essensys-hub/essensys-doc/archi/index.md

# Architecture du Systeme Essensys

Cette documentation decrit l'architecture logicielle et systeme de l'ecosysteme Essensys, en s'appuyant sur les principes du modele C4 (Context, Containers, Components, Code) et l'approche *Clean Architecture*.

## 1. Contexte du Systeme (System Context)

Le systeme Essensys est une solution domotique concue initialement autour de cartes materielles embarquees (BP_MQX_ETH). Le defi majeur de l'architecture actuelle est de moderniser l'acces et le controle de ce materiel "legacy" tout en assurant une retrocompatibilite totale.

### Objectif Principal

Fournir une interface de controle moderne, securisee et performante (via des dashboards web, mobile, ou messagerie WhatsApp) tout en dialoguant avec un parc materiel existant dont les capacites reseau et logiques (firmware C sur Coldfire MCF52259) sont figees.

### Diagramme de Contexte

```mermaid
graph TB
    user["👤 Utilisateur Final<br/>Navigateur / Mobile / WhatsApp"]
    admin["🔧 Administrateur<br/>SSH / HTTPS / Control Plane"]

    essensys["🏠 Ecosysteme Essensys<br/>Chauffage, volets, eclairage,<br/>alarme, securite"]

    hardware["🔌 Cartes BP_MQX_ETH<br/>Coldfire MCF52259 / MQX RTOS"]
    whatsapp["📱 WhatsApp<br/>Notifications via OpenClaw"]
    homeassistant["🏠 Home Assistant<br/>MQTT Discovery"]
    linky["⚡ Compteur Linky<br/>Teleinfo UART 1200 bauds"]
    unifi["📷 UniFi Protect<br/>Cameras IP"]
    dockerhub["🐳 Docker Hub<br/>Registry images"]
    github["⚙️ GitHub Actions<br/>CI/CD multi-arch"]

    user -->|HTTPS / WhatsApp| essensys
    admin -->|SSH / HTTPS| essensys
    essensys <-->|Polling HTTP 2s<br/>Port 80 / LAN| hardware
    essensys <-->|API WhatsApp Web| whatsapp
    essensys <-->|MQTT| homeassistant
    hardware <---|UART 1200 bauds| linky
    essensys -->|HTTPS| unifi
    github -->|Docker Push ARM64/AMD64| dockerhub
    admin -->|Git Push| github

    classDef system fill:#438DD5,stroke:#2E6295,color:#fff
    classDef external fill:#999,stroke:#666,color:#fff
    classDef person fill:#08427B,stroke:#052E56,color:#fff

    class essensys system
    class hardware,whatsapp,homeassistant,linky,unifi,dockerhub,github external
    class user,admin person
```
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
