essensys-hub/essensys-doc/docs/etudes/img/banc/cartes.png

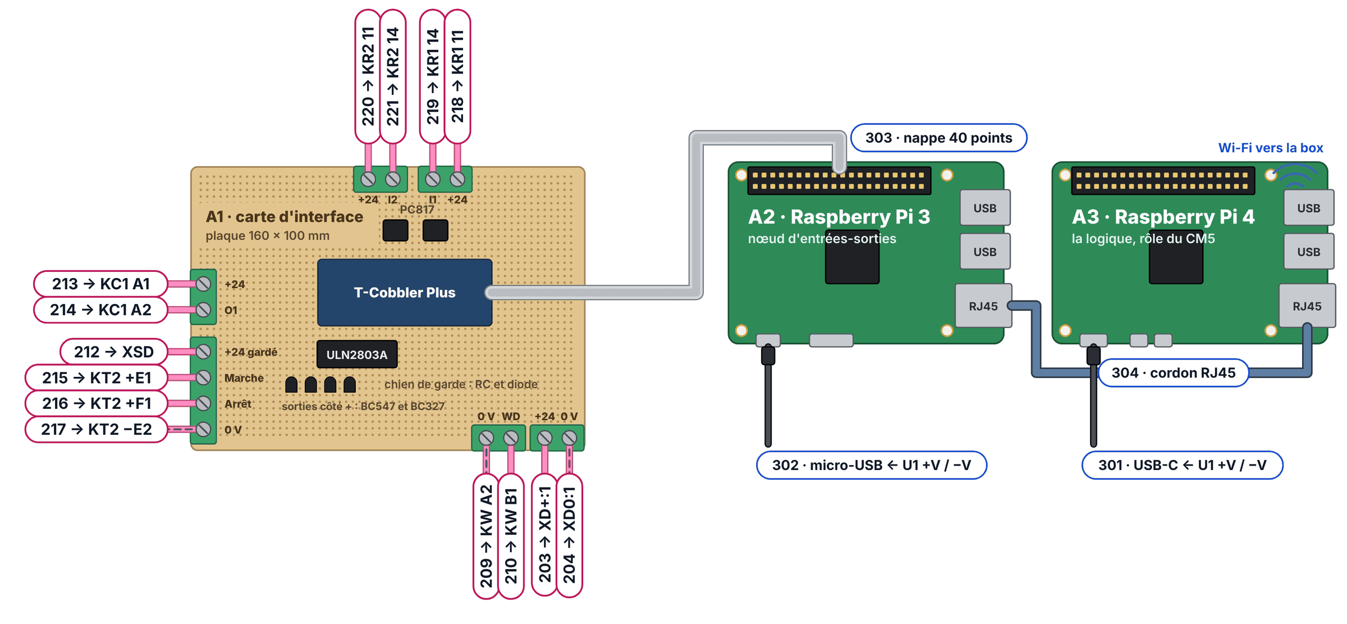
docs/etudes/img/banc/cartes.png
