essensys-hub/essensys-doc/docs/etudes/img/banc/ensemble.png

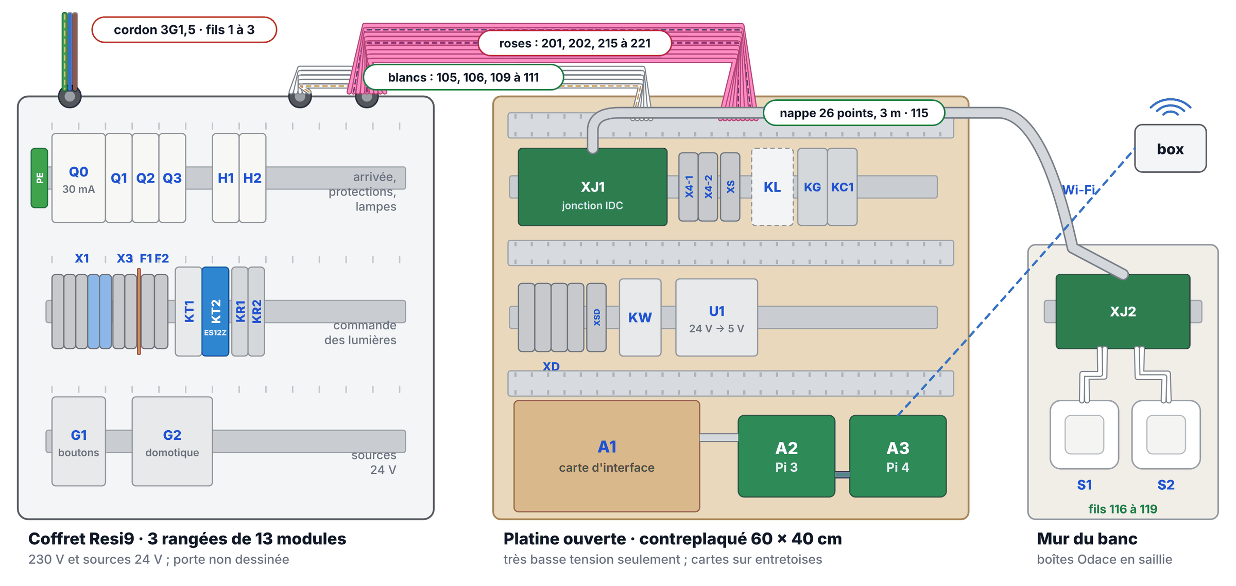
docs/etudes/img/banc/ensemble.png
