essensys-hub/essensys-doc/docs/etudes/img/banc/fritzing-une-lumiere.png

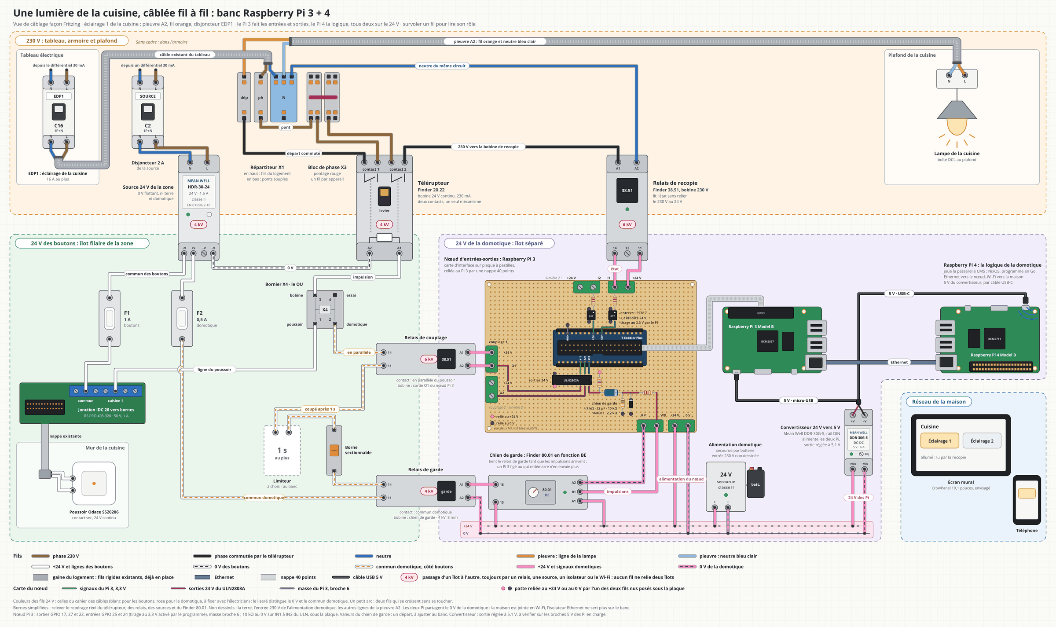
docs/etudes/img/banc/fritzing-une-lumiere.png
