essensys-hub/essensys-doc/docs/etudes/img/banc/rail-C1.png

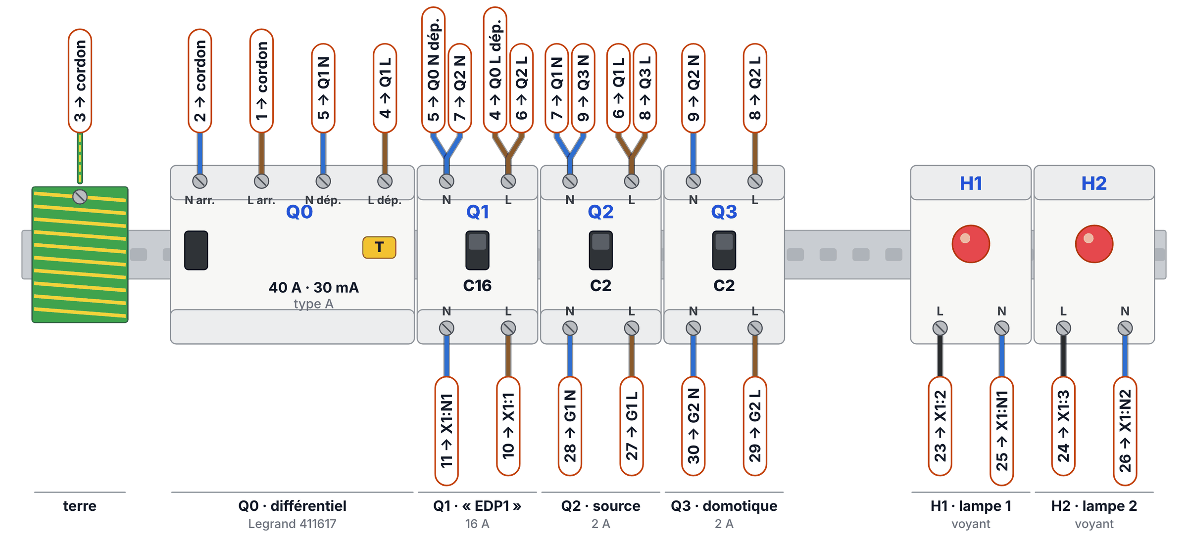
docs/etudes/img/banc/rail-C1.png
