essensys-hub/essensys-doc/docs/etudes/img/banc/rail-C3.png

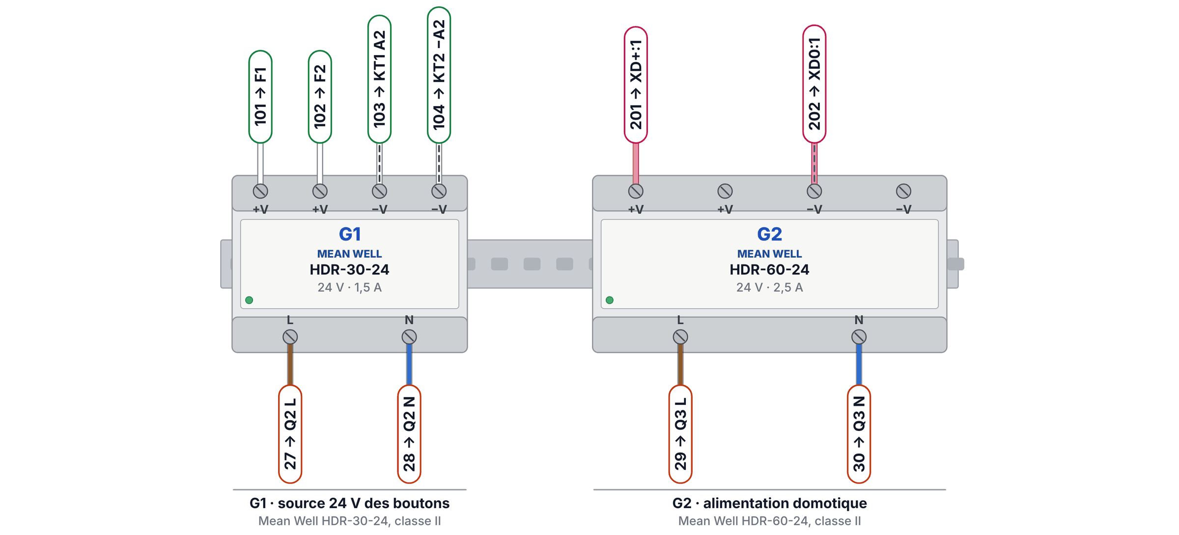
docs/etudes/img/banc/rail-C3.png
