essensys-hub/essensys-doc/docs/etudes/img/banc/rail-P1.png

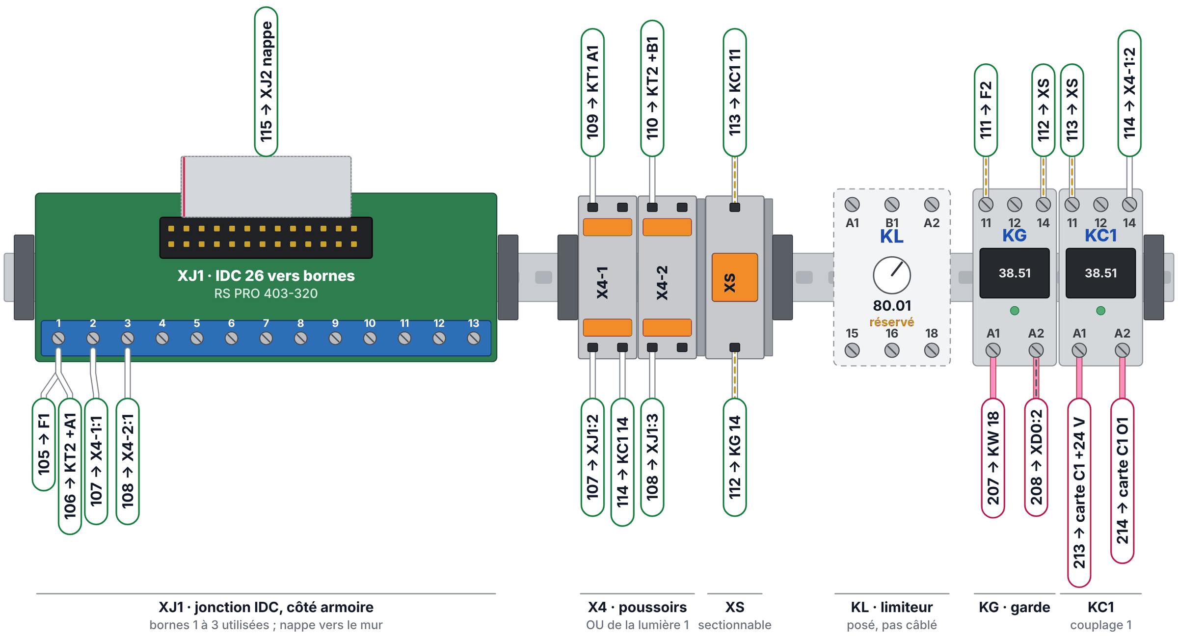
docs/etudes/img/banc/rail-P1.png
