essensys-hub/essensys-doc/docs/etudes/remplacement-armoire/img/alimentation-revpi.png

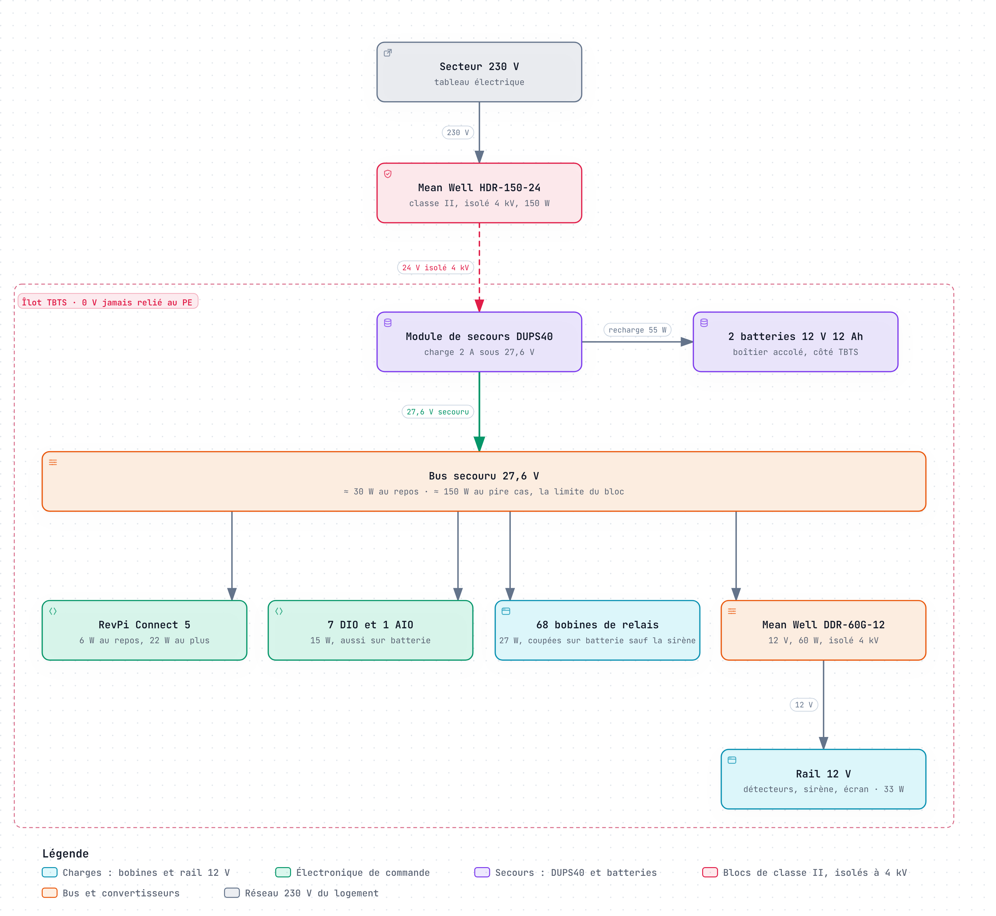
docs/etudes/remplacement-armoire/img/alimentation-revpi.png
