essensys-hub/essensys-doc/docs/etudes/remplacement-armoire/img/architecture-revpi-cible.png

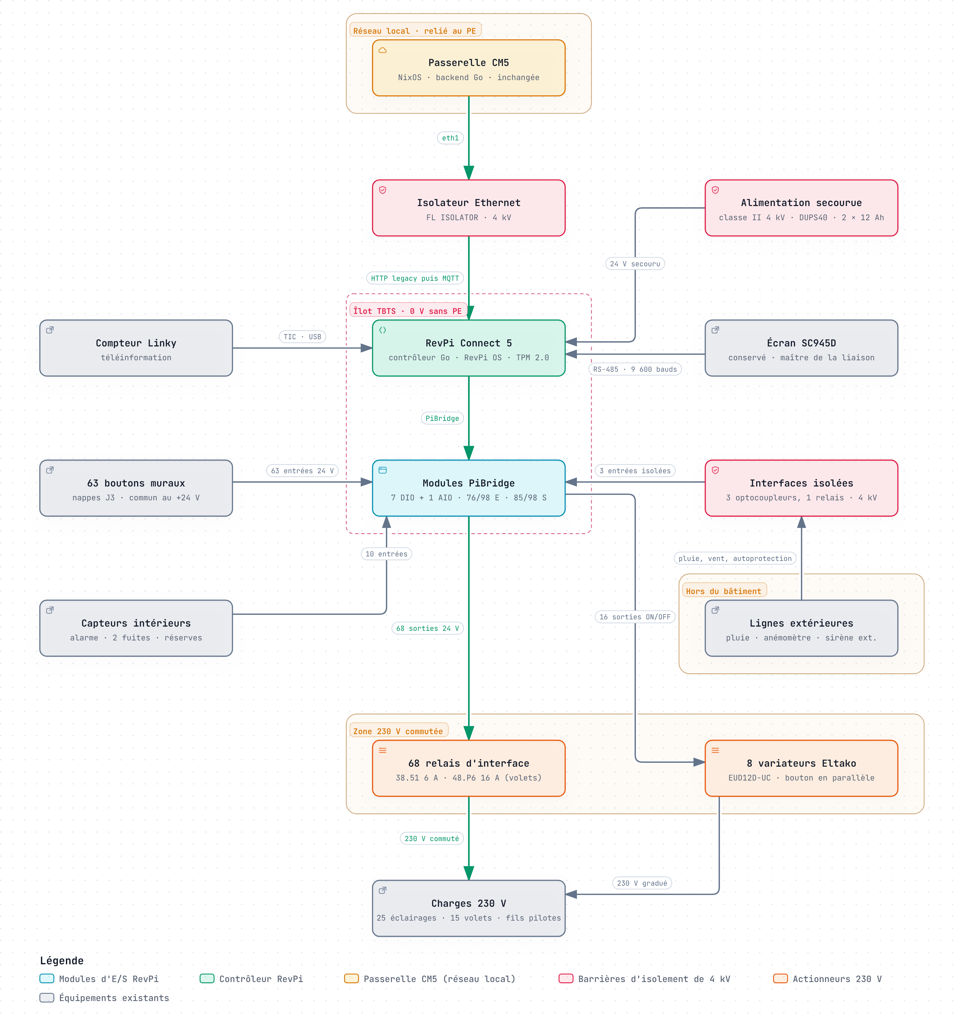
docs/etudes/remplacement-armoire/img/architecture-revpi-cible.png
