essensys-hub/essensys-doc/docs/etudes/remplacement-armoire/img/detail-jonctions-rpi.jpg

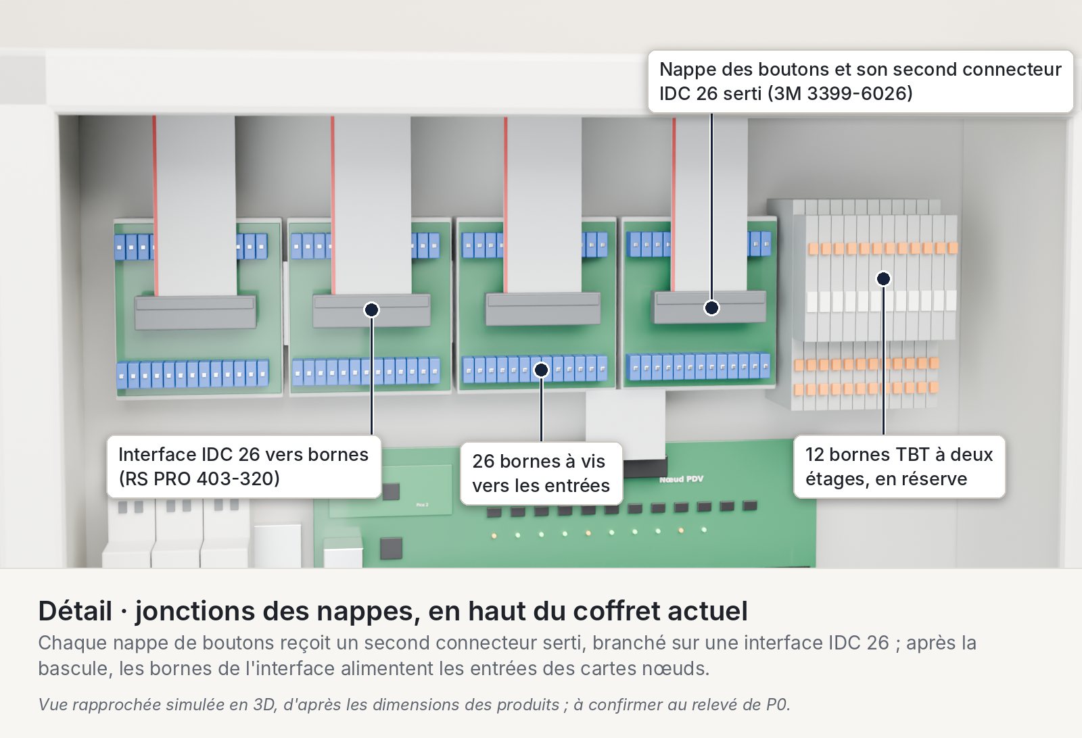
docs/etudes/remplacement-armoire/img/detail-jonctions-rpi.jpg
