essensys-hub/essensys-doc/docs/etudes/remplacement-armoire/img/detail-phases-revpi.jpg

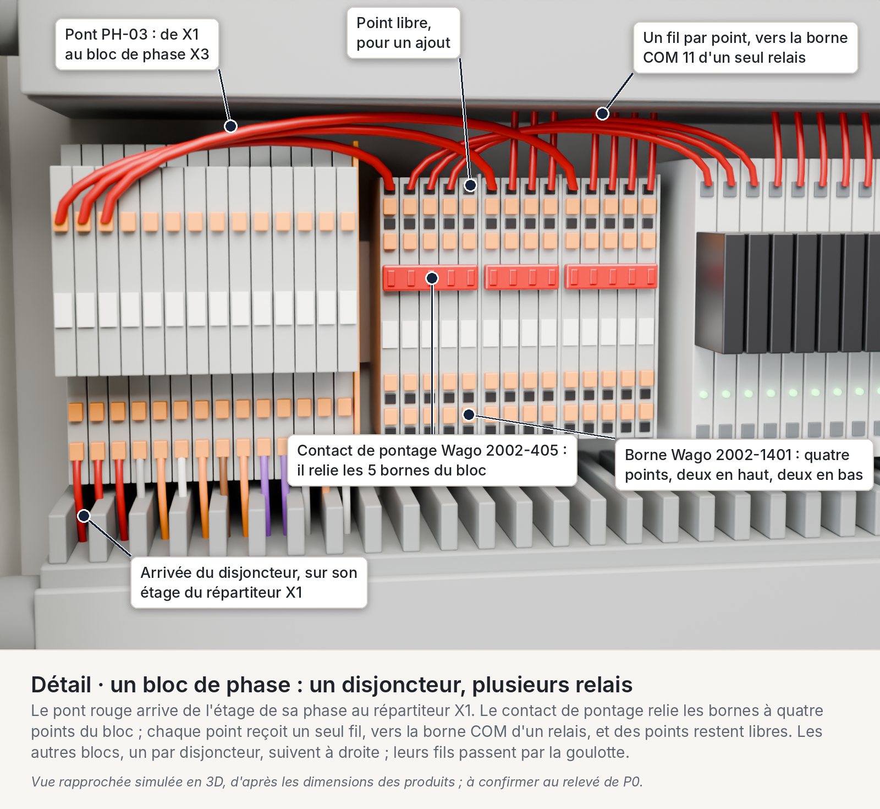
docs/etudes/remplacement-armoire/img/detail-phases-revpi.jpg
