essensys-hub/essensys-doc/docs/etudes/remplacement-armoire/img/detail-phases-rpi.jpg

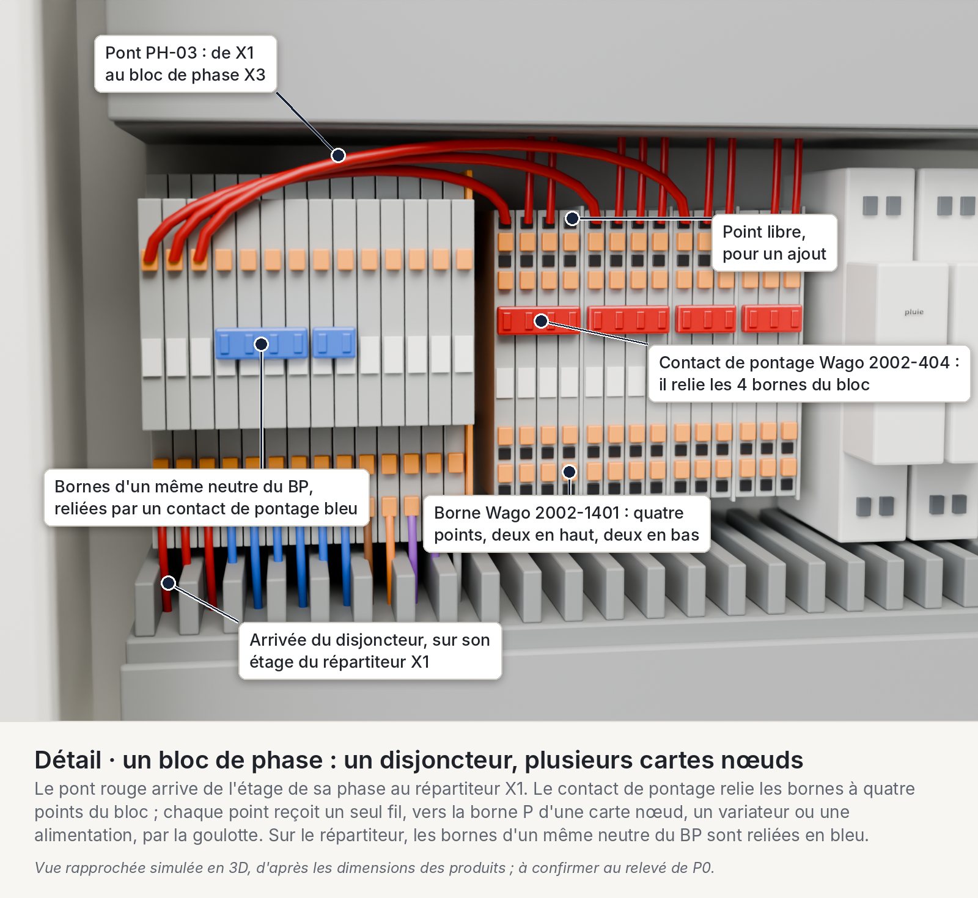
docs/etudes/remplacement-armoire/img/detail-phases-rpi.jpg
