essensys-hub/essensys-doc/docs/etudes/remplacement-armoire/img/detail-repartiteur-revpi.jpg

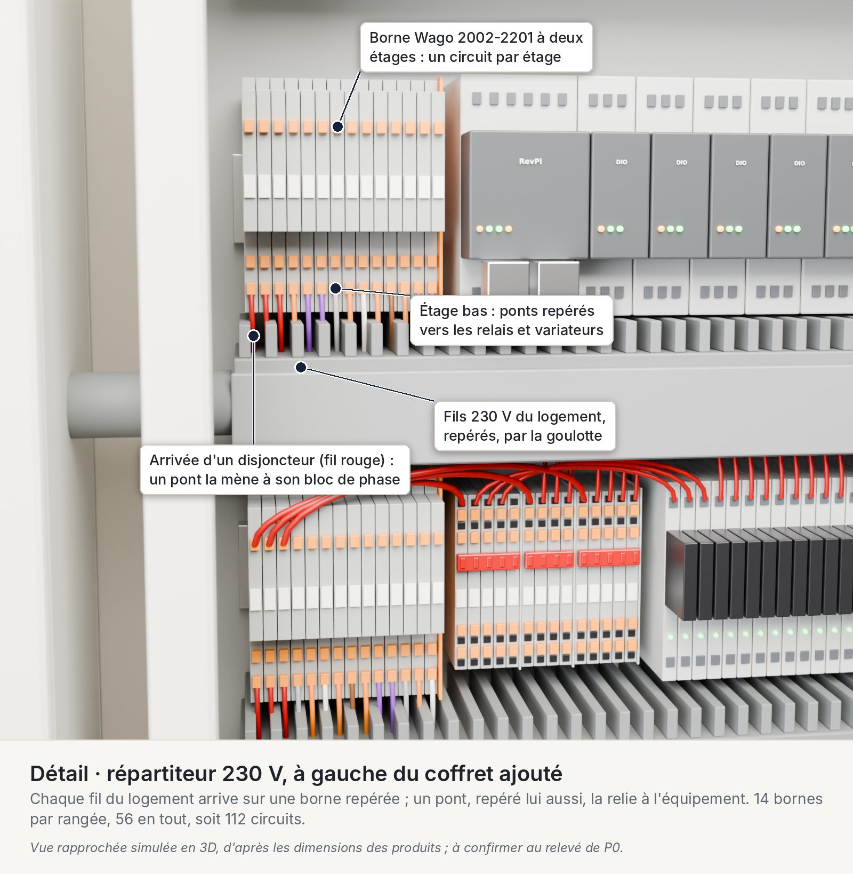
docs/etudes/remplacement-armoire/img/detail-repartiteur-revpi.jpg
