essensys-hub/essensys-doc/docs/etudes/remplacement-armoire/img/detail-repartiteur-rpi.jpg

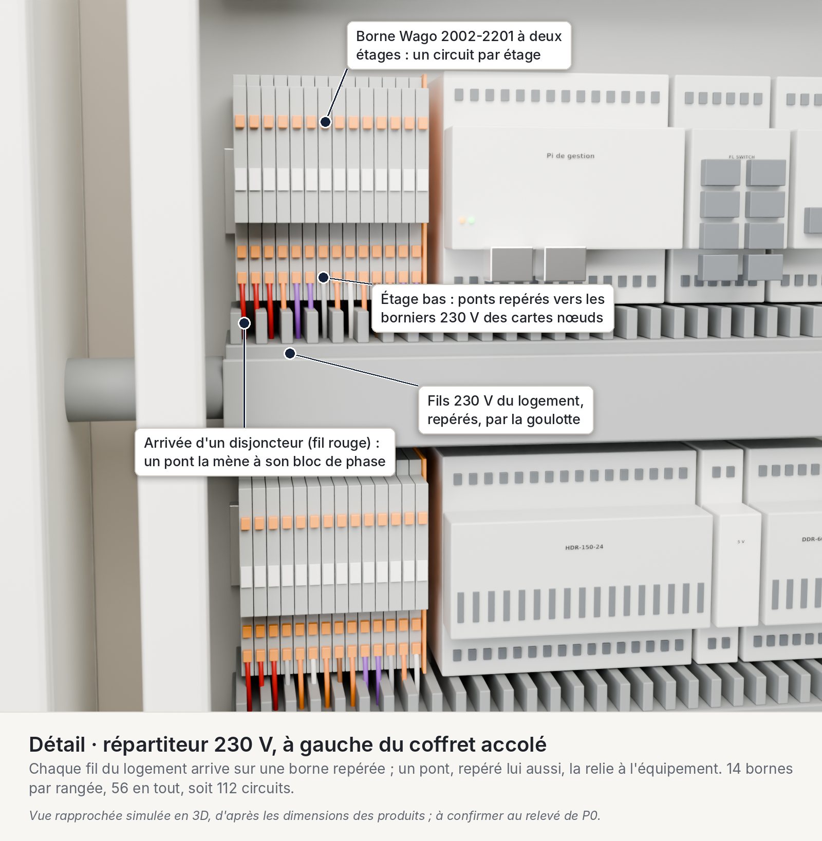
docs/etudes/remplacement-armoire/img/detail-repartiteur-rpi.jpg
