essensys-hub/essensys-doc/docs/etudes/remplacement-armoire/img/implantation-rpi.png

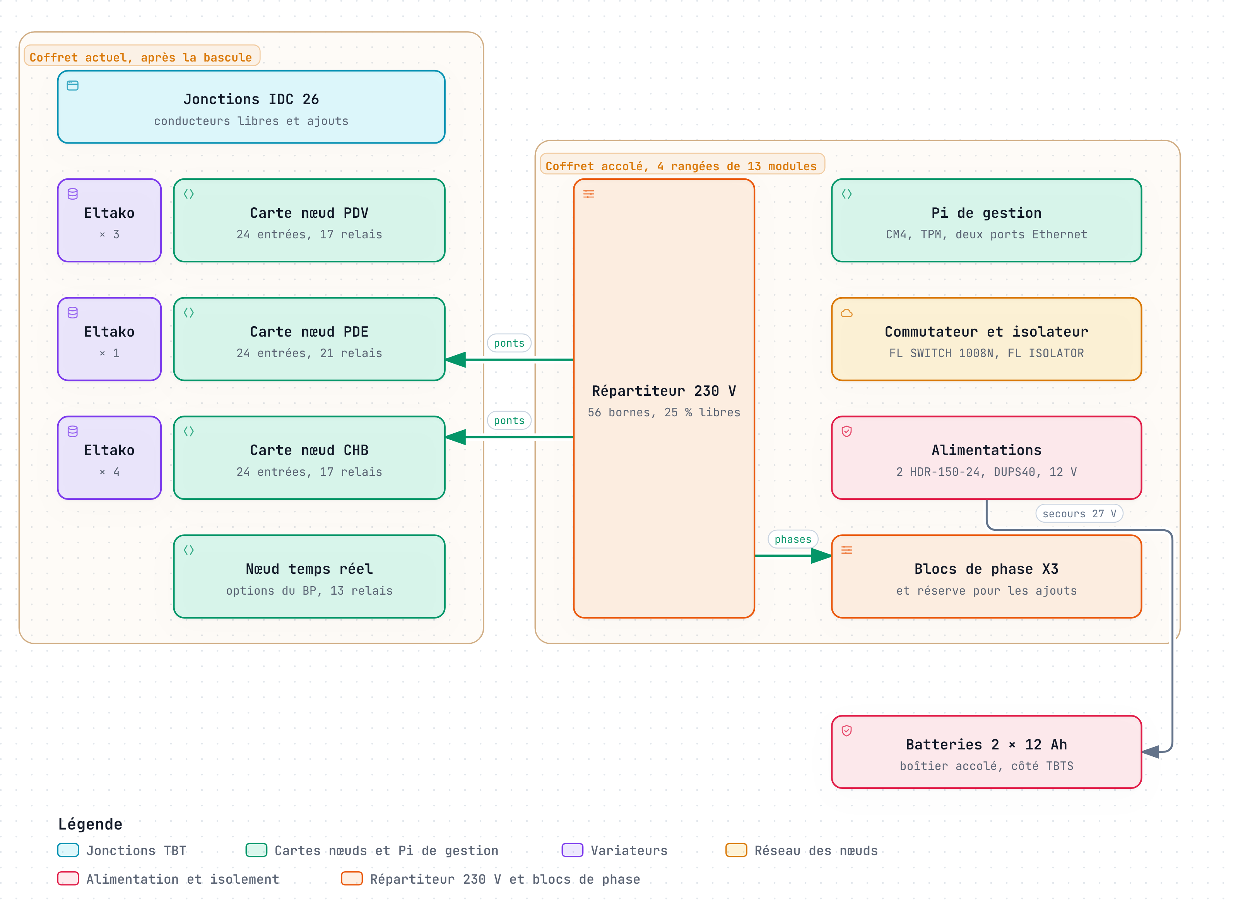
docs/etudes/remplacement-armoire/img/implantation-rpi.png
