essensys-hub/essensys-doc/docs/etudes/remplacement-armoire/marche/archify/eltako-series-14-derivation.png

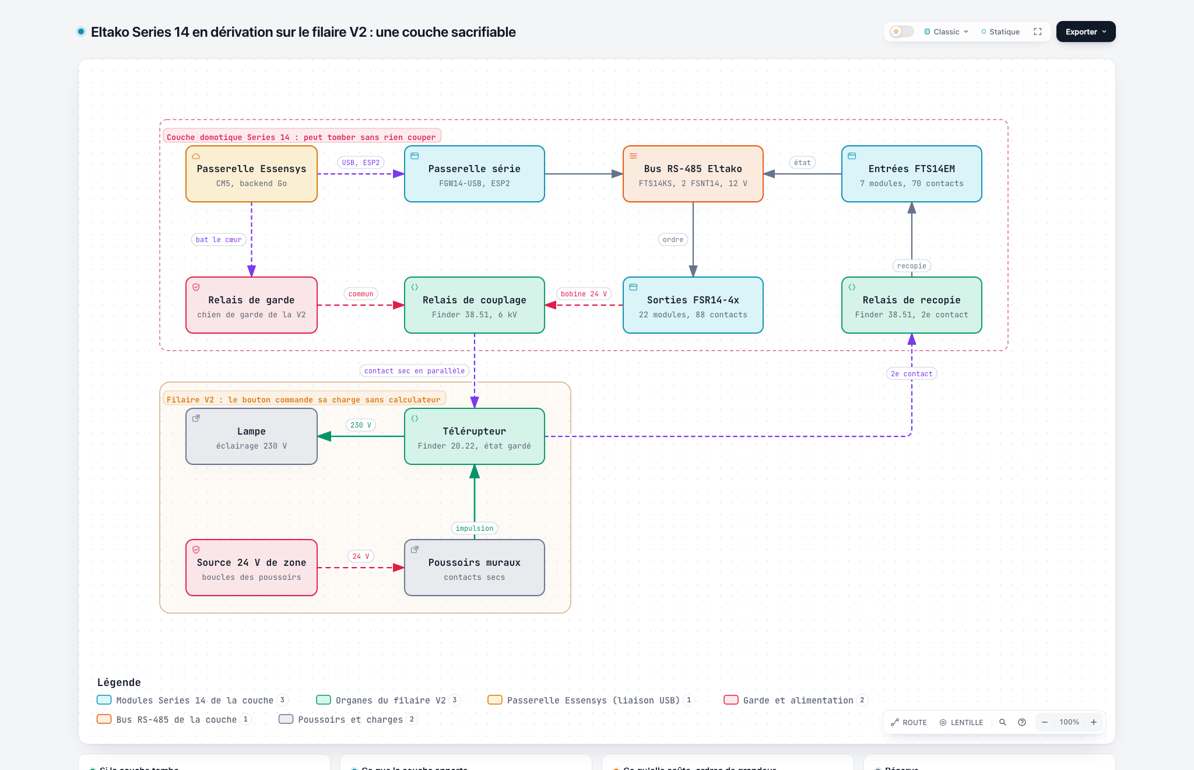
docs/etudes/remplacement-armoire/marche/archify/eltako-series-14-derivation.png
