essensys-hub/essensys-doc/docs/etudes/remplacement-armoire/marche/archify/esphome-rail-din-derivation.png

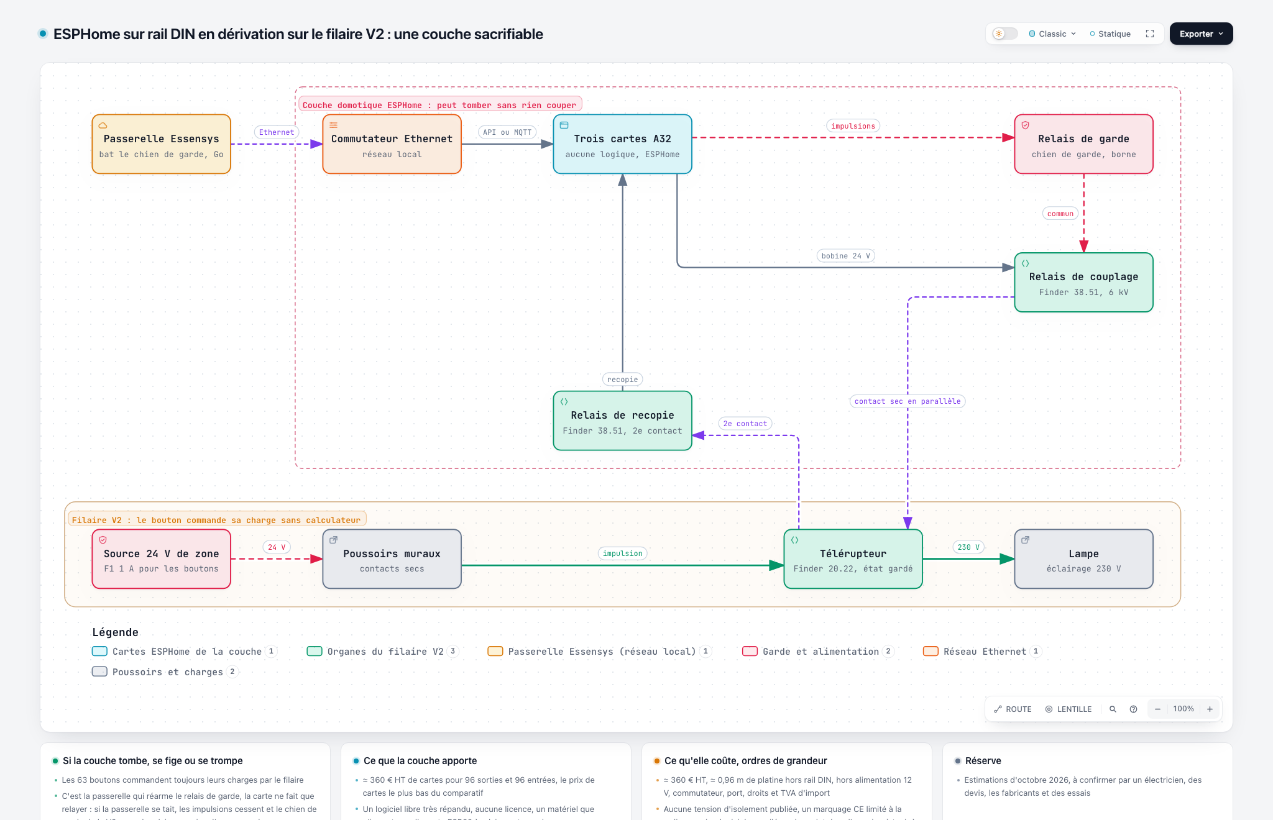
docs/etudes/remplacement-armoire/marche/archify/esphome-rail-din-derivation.png
