essensys-hub/essensys-doc/docs/etudes/remplacement-armoire/marche/archify/homematic-ip-wired-seule.png

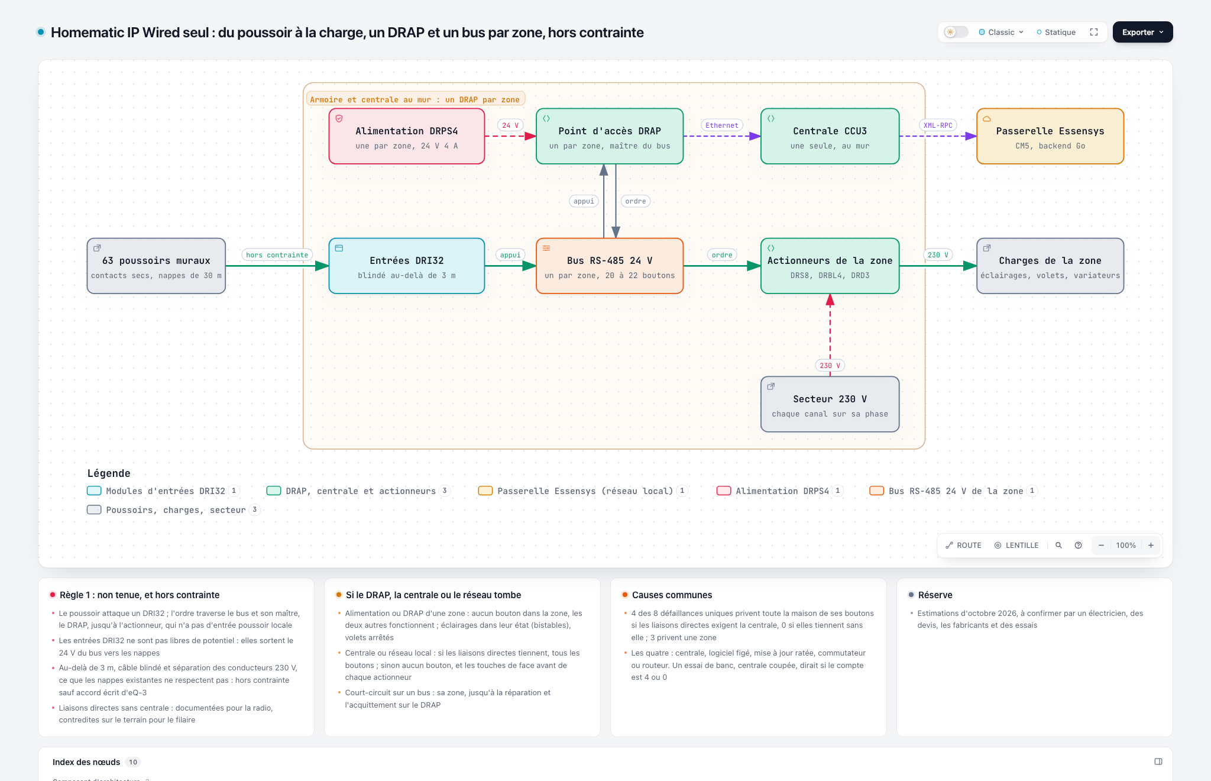
docs/etudes/remplacement-armoire/marche/archify/homematic-ip-wired-seule.png
