essensys-hub/essensys-doc/docs/etudes/remplacement-armoire/marche/archify/loxone-derivation.png

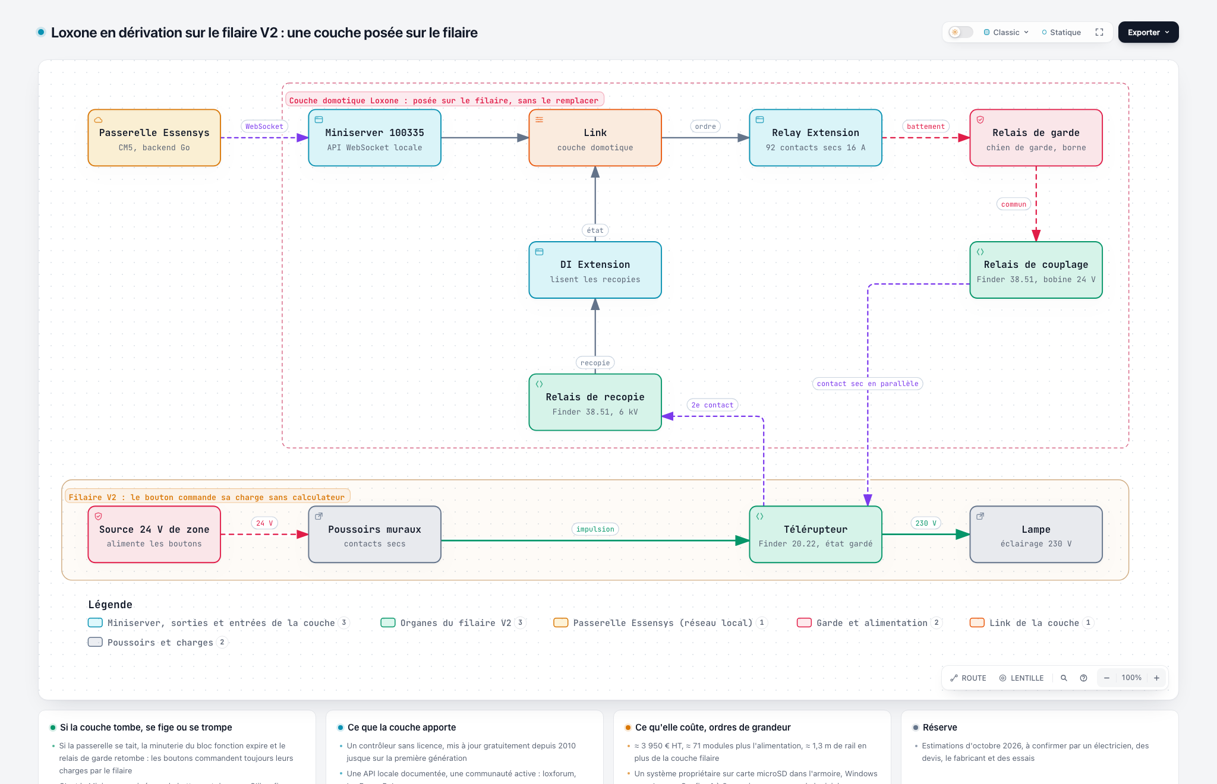
docs/etudes/remplacement-armoire/marche/archify/loxone-derivation.png
