essensys-hub/essensys-doc/docs/etudes/remplacement-armoire/marche/archify/niko-home-control-seule.png

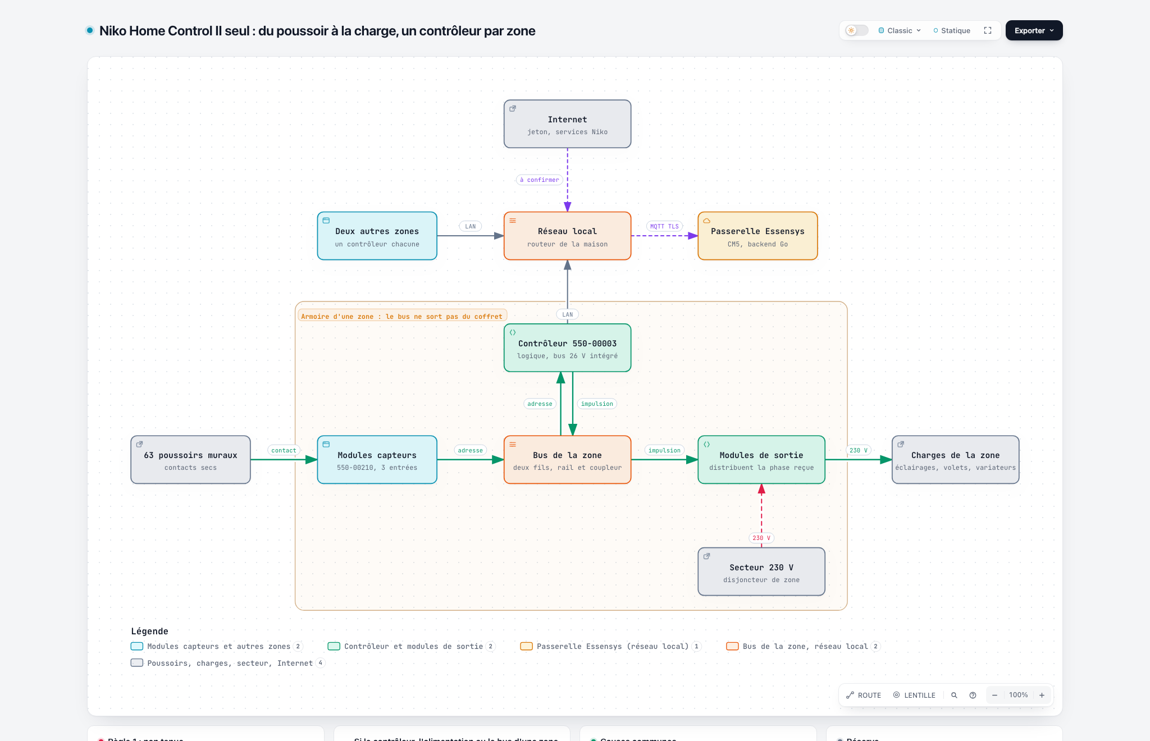
docs/etudes/remplacement-armoire/marche/archify/niko-home-control-seule.png
