essensys-hub/essensys-doc/docs/etudes/remplacement-armoire/marche/archify/shelly-pro-seule.png

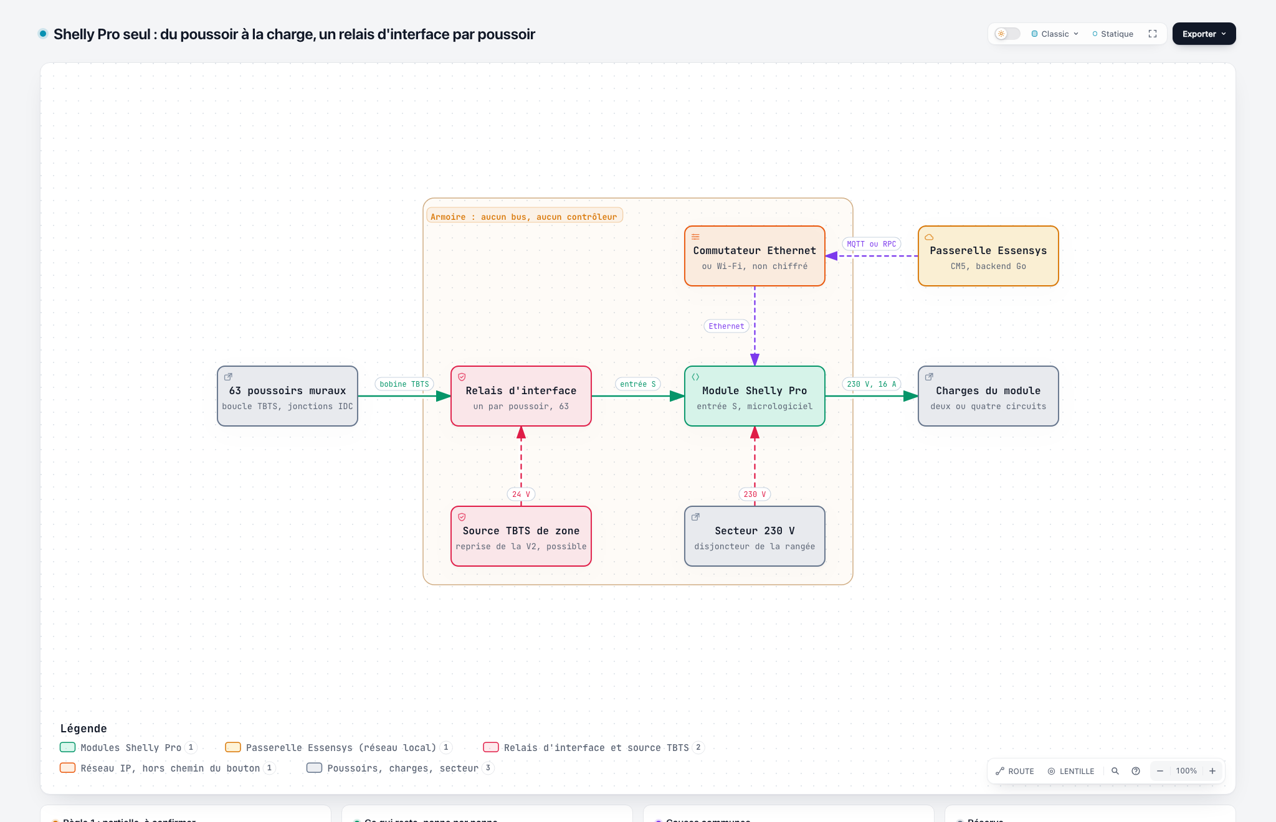
docs/etudes/remplacement-armoire/marche/archify/shelly-pro-seule.png
