essensys-hub/essensys-doc/docs/etudes/remplacement-armoire/marche/archify/wago-pfc200-derivation.png

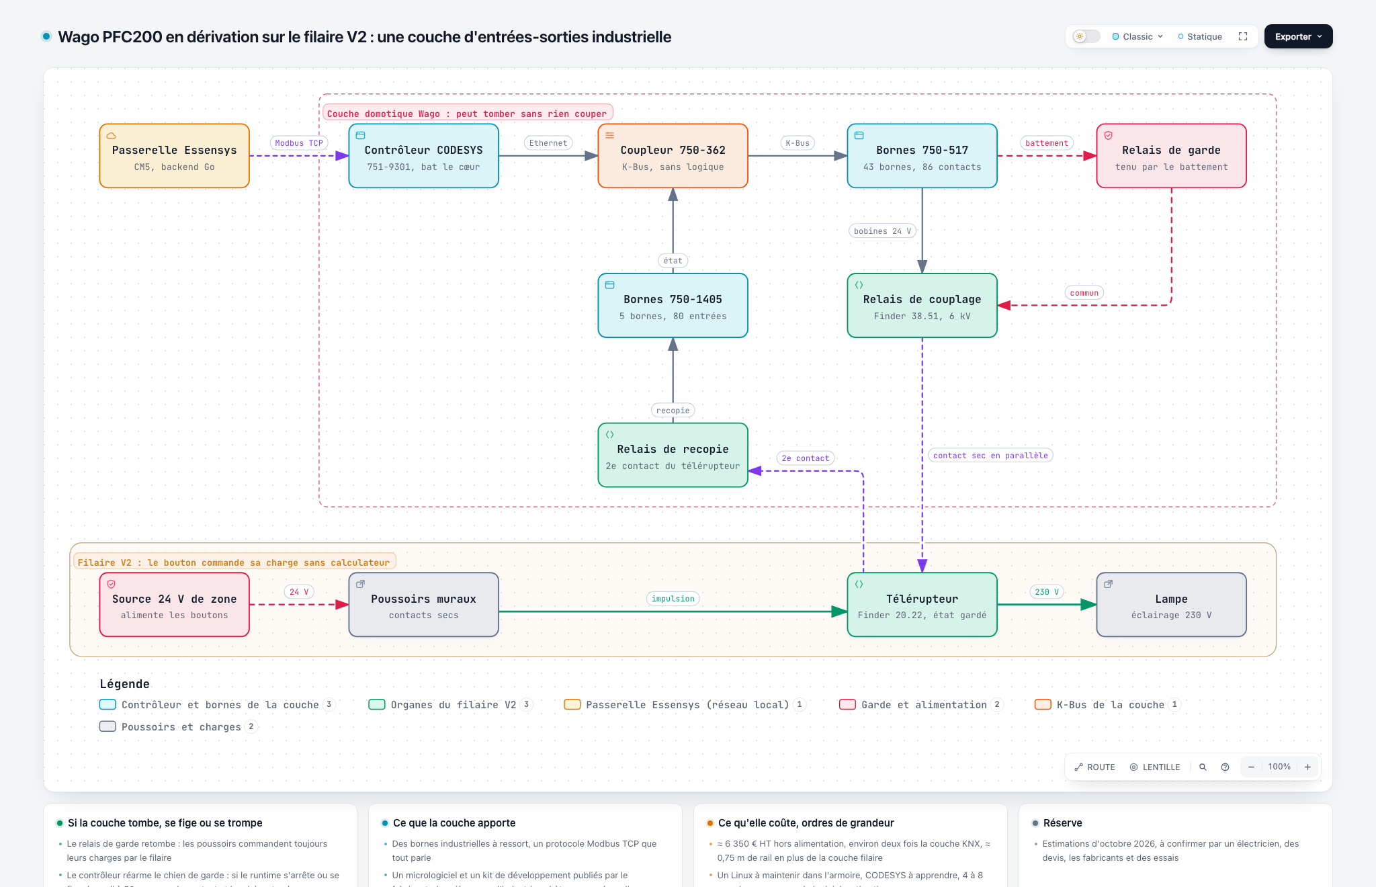
docs/etudes/remplacement-armoire/marche/archify/wago-pfc200-derivation.png
