essensys-hub/essensys-doc/docs/etudes/remplacement-armoire/marche/fritzing/domintell_breadboard.png

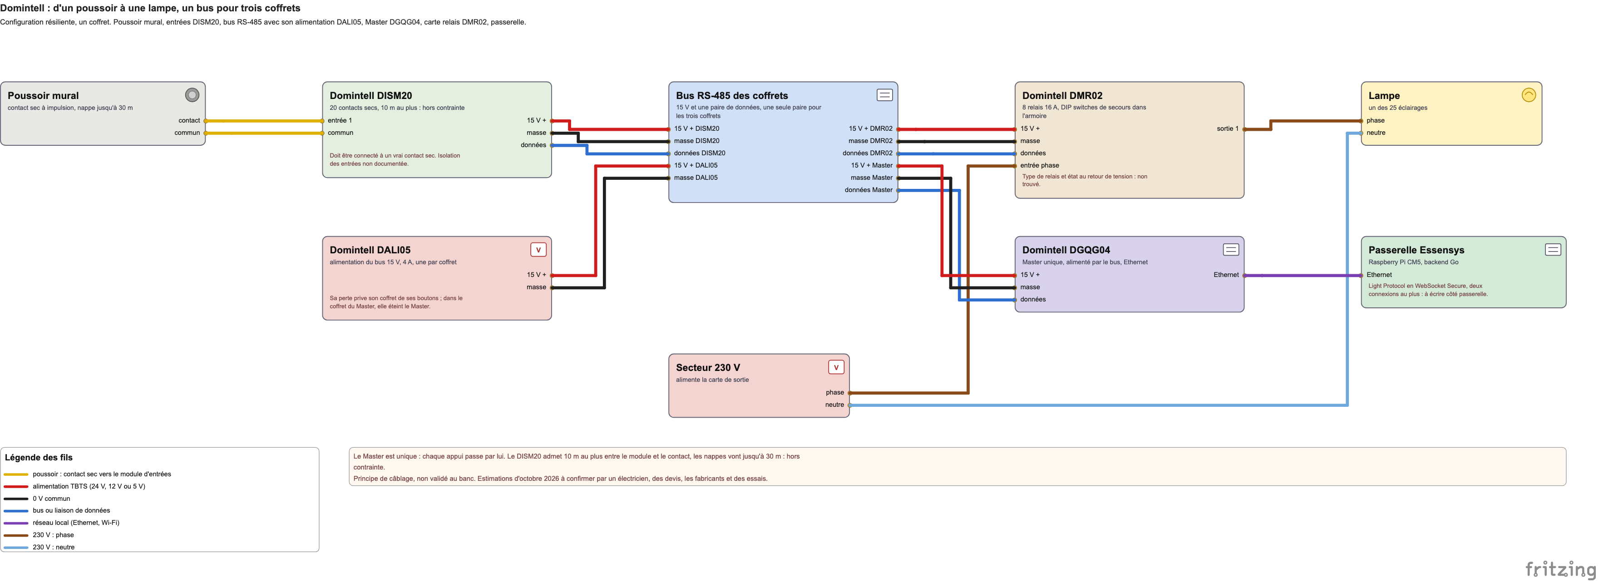
docs/etudes/remplacement-armoire/marche/fritzing/domintell_breadboard.png
