essensys-hub/essensys-doc/docs/etudes/remplacement-armoire/marche/fritzing/eltako-series-14_breadboard.png

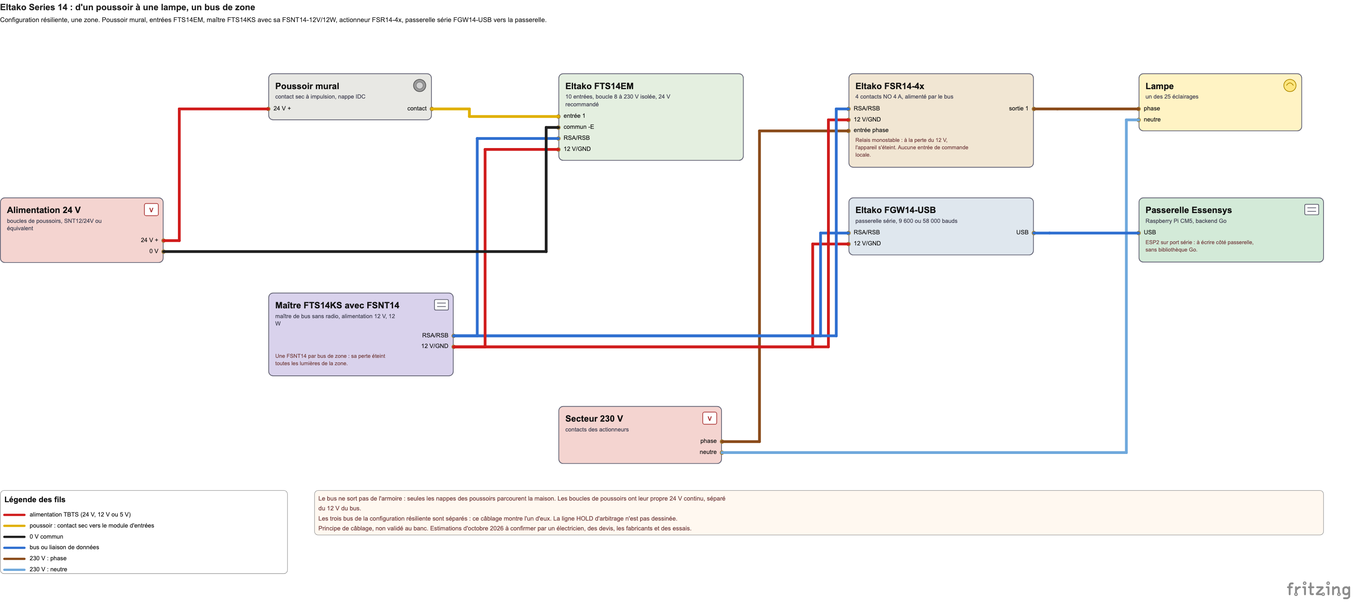
docs/etudes/remplacement-armoire/marche/fritzing/eltako-series-14_breadboard.png
