essensys-hub/essensys-doc/docs/etudes/remplacement-armoire/marche/fritzing/homematic-ip-wired_breadboard.png

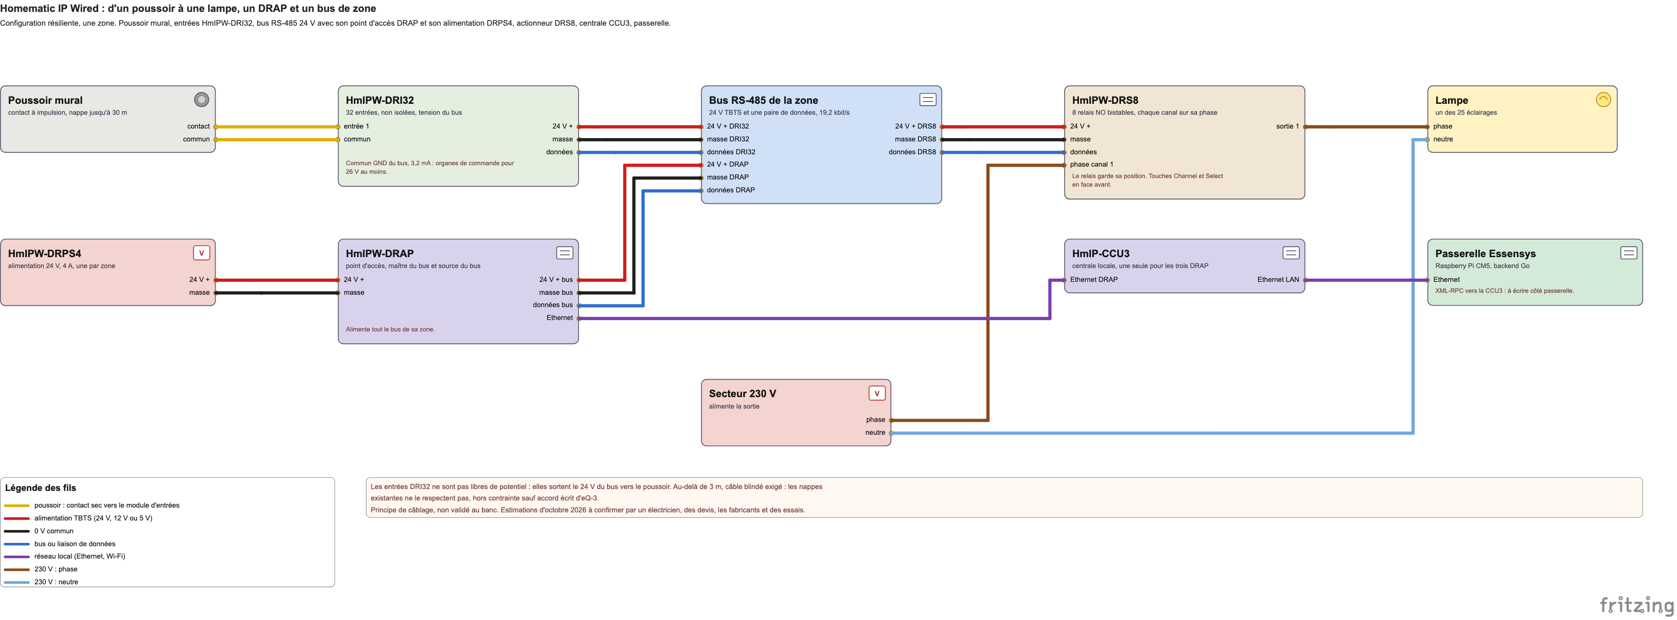
docs/etudes/remplacement-armoire/marche/fritzing/homematic-ip-wired_breadboard.png
