essensys-hub/essensys-doc/docs/etudes/remplacement-armoire/marche/fritzing/knx_breadboard.png

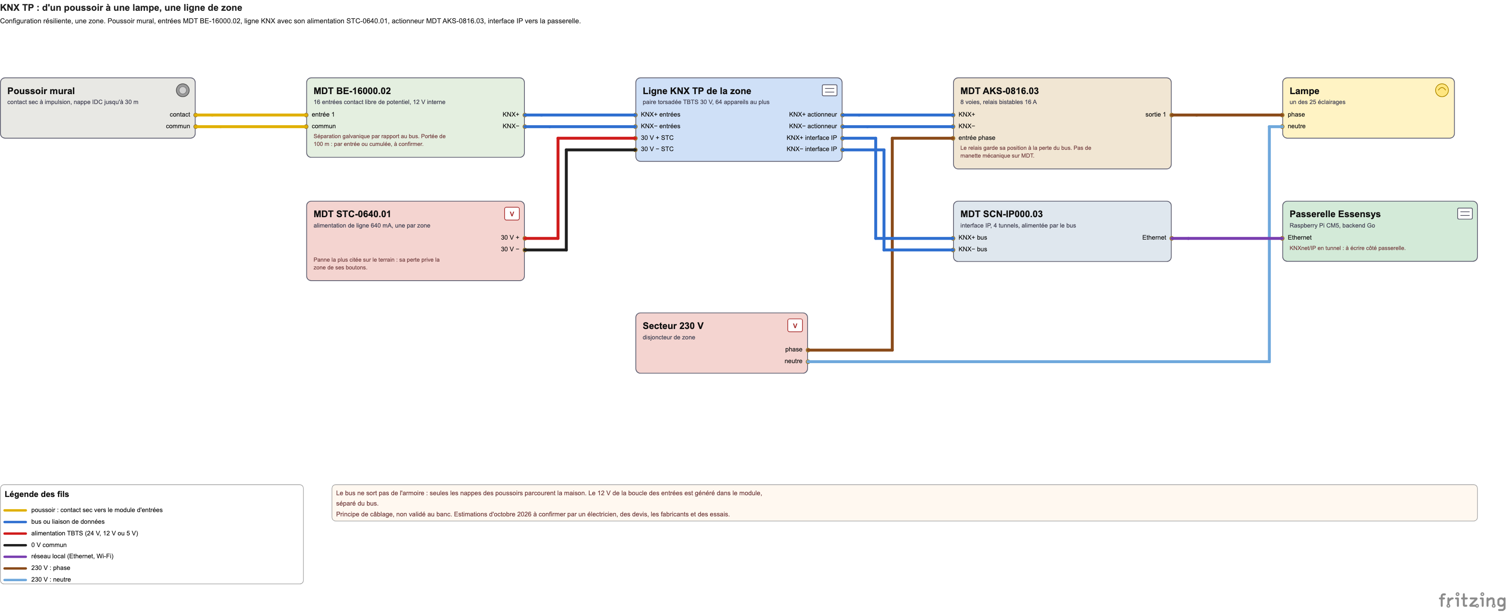
docs/etudes/remplacement-armoire/marche/fritzing/knx_breadboard.png
