essensys-hub/essensys-doc/docs/etudes/remplacement-armoire/marche/fritzing/wago-pfc200_breadboard.png

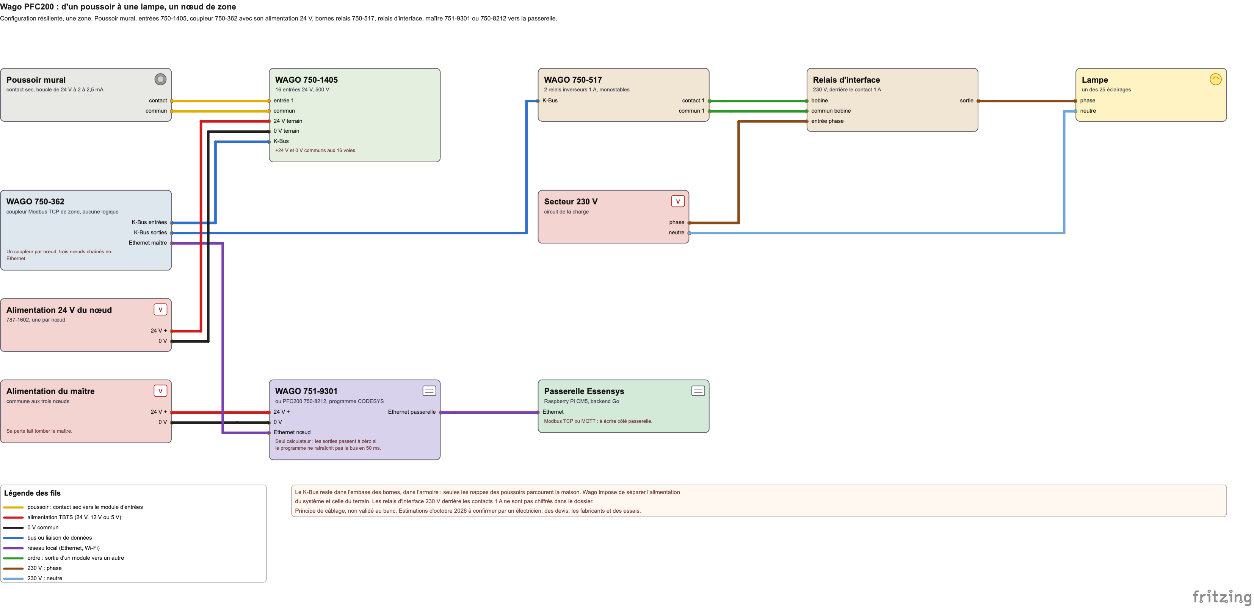
docs/etudes/remplacement-armoire/marche/fritzing/wago-pfc200_breadboard.png
