essensys-hub/essensys-doc/docs/etudes/remplacement-armoire/v2/img/filaire-deux-couches.png

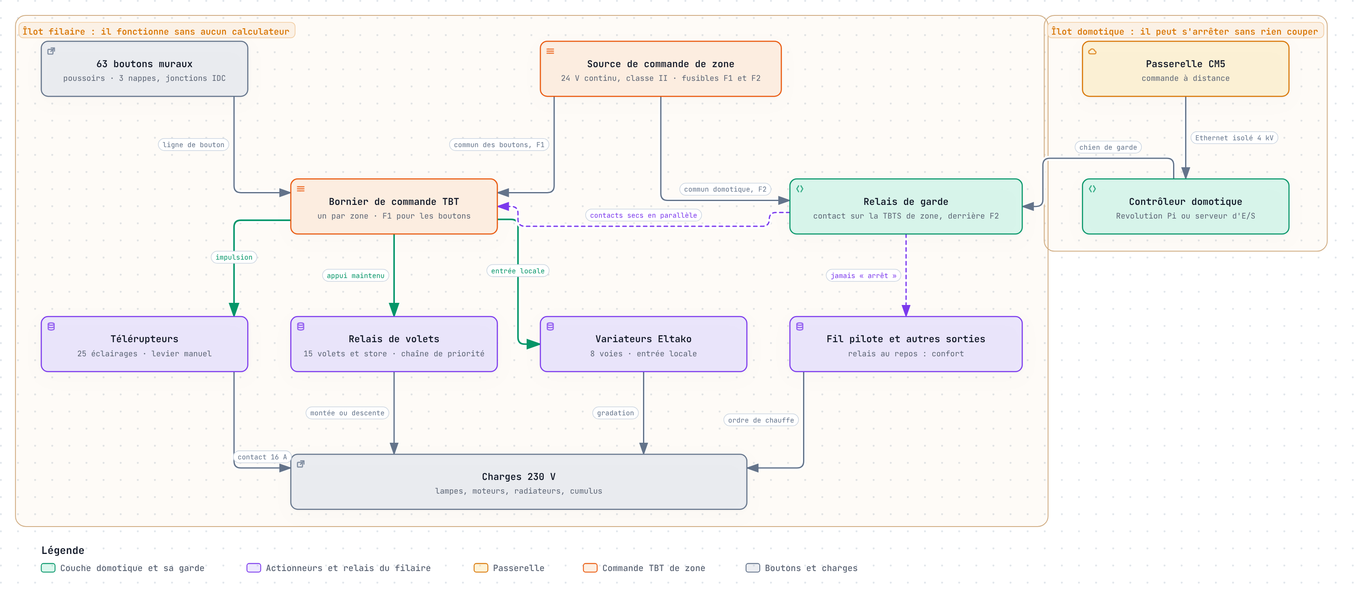
docs/etudes/remplacement-armoire/v2/img/filaire-deux-couches.png
