essensys-hub/essensys-doc/docs/etudes/remplacement-armoire/v2/img/filaire-principe.png

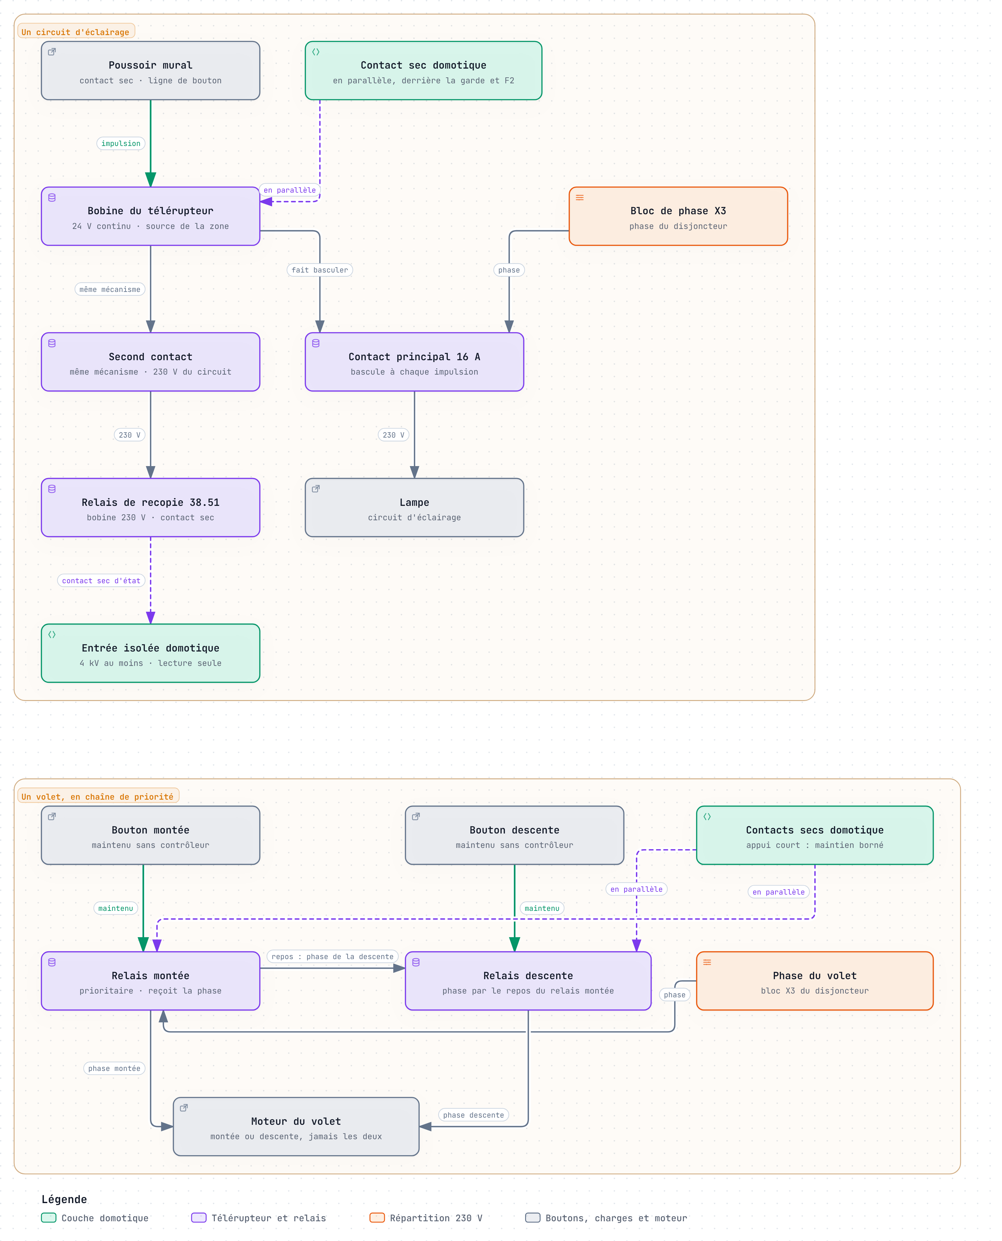
docs/etudes/remplacement-armoire/v2/img/filaire-principe.png
