essensys-hub/essensys-doc/docs/etudes/remplacement-armoire/v2/img/filaire-une-lumiere-fritzing.png

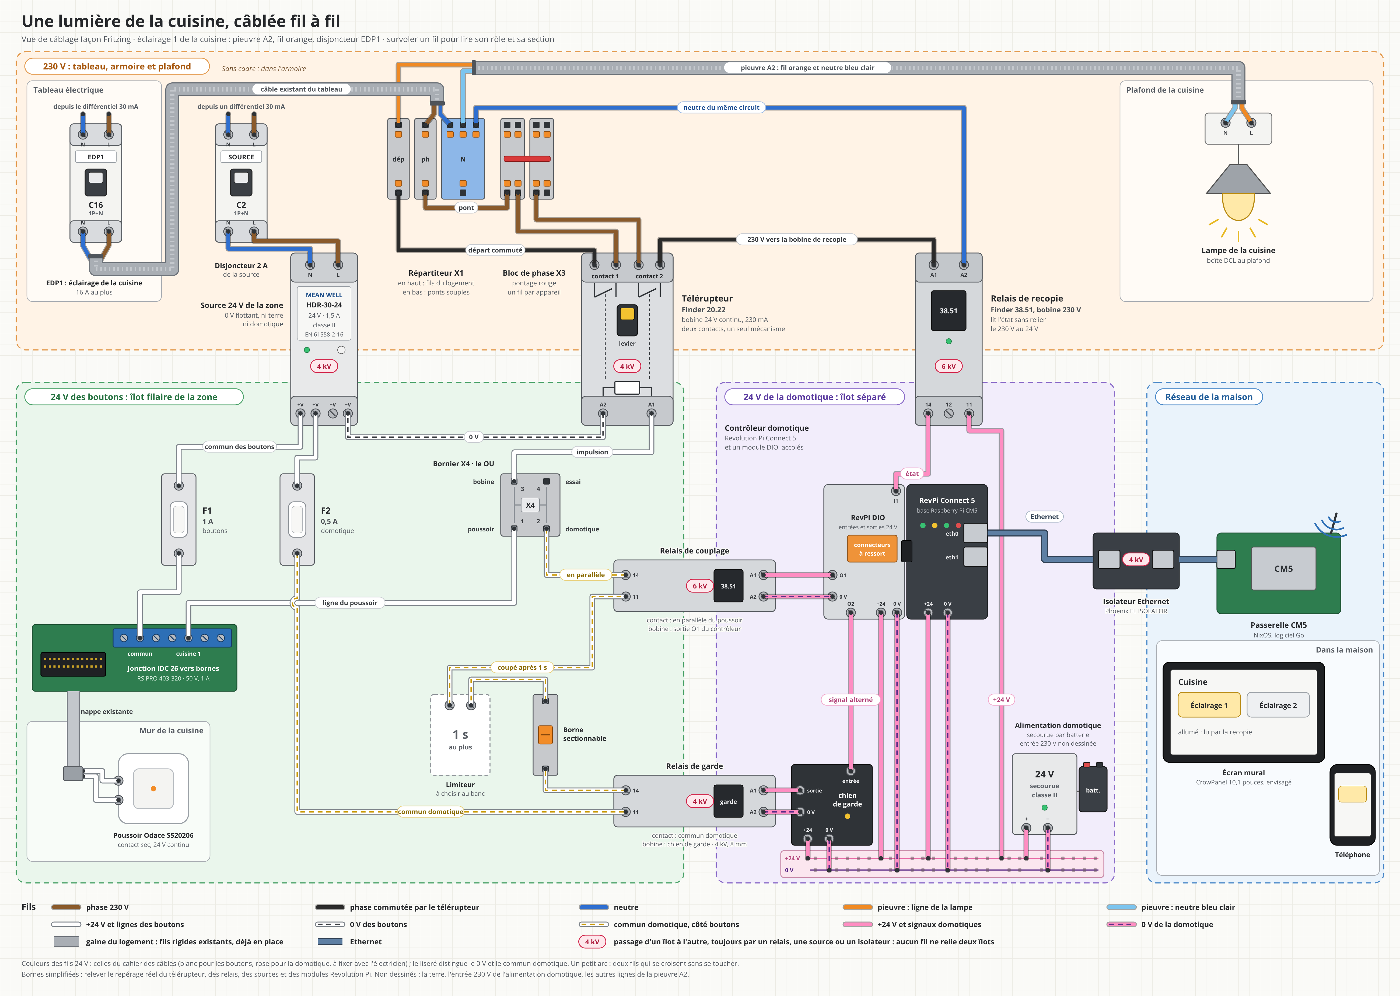
docs/etudes/remplacement-armoire/v2/img/filaire-une-lumiere-fritzing.png
