essensys-hub/essensys-doc/docs/etudes/remplacement-armoire/v2/img/filaire-vue-complete.png

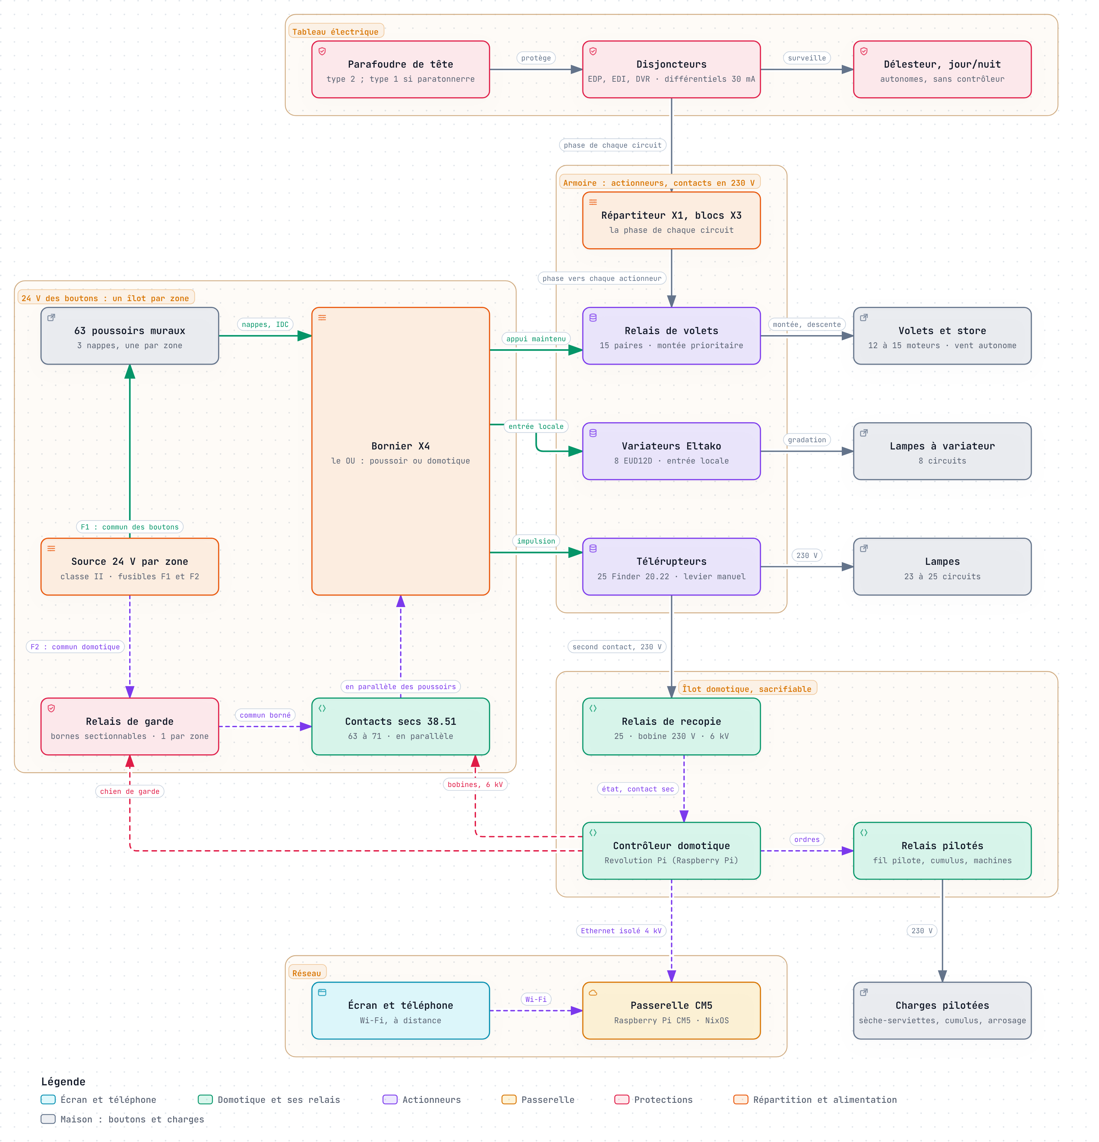
docs/etudes/remplacement-armoire/v2/img/filaire-vue-complete.png
