essensys-hub/essensys-doc/docs/retex/foudre-2026/img/banc-bp-d33-gros-plan.jpg

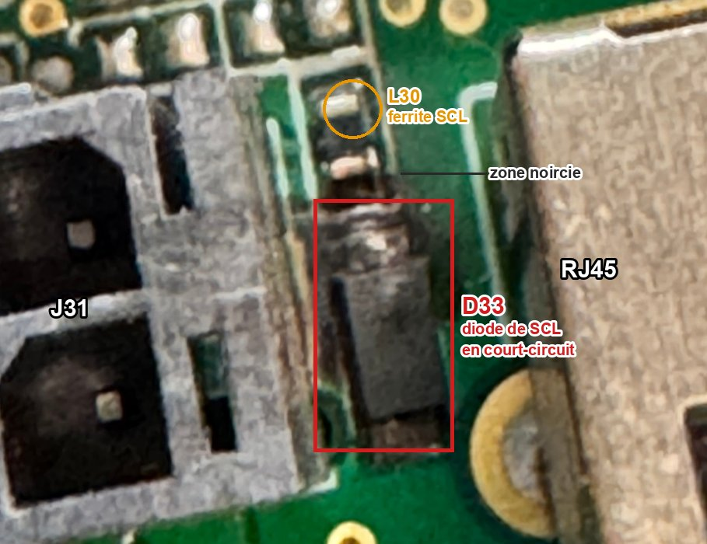
docs/retex/foudre-2026/img/banc-bp-d33-gros-plan.jpg
