essensys-hub/essensys-doc/newsletters/2026-06-volets/assets/01-dashboard.png

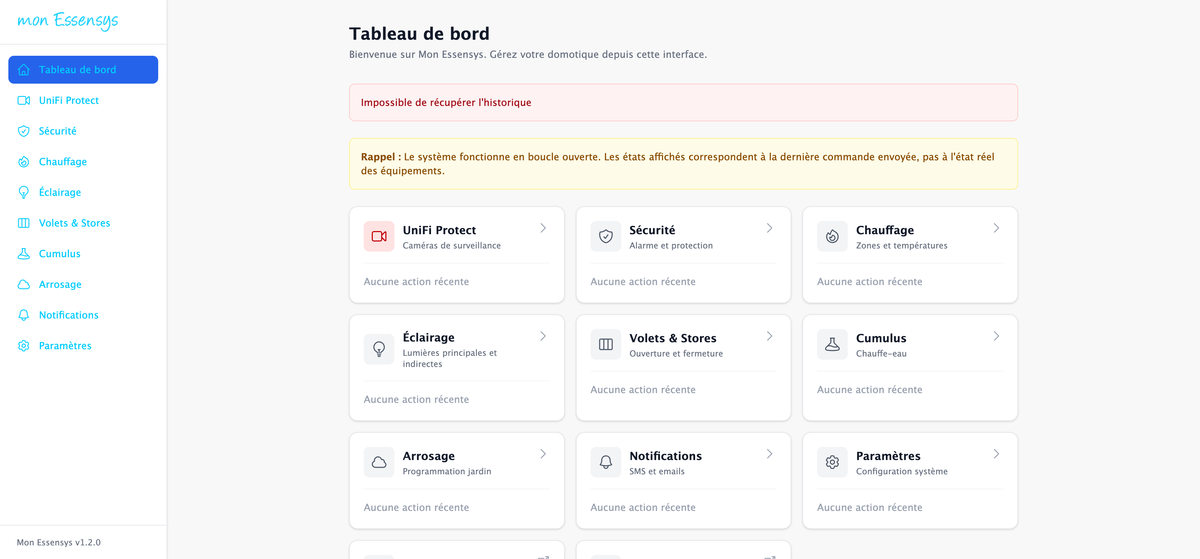
newsletters/2026-06-volets/assets/01-dashboard.png
