essensys-hub/essensys-doc/newsletters/2026-06-volets/assets/02-volets-controle.png

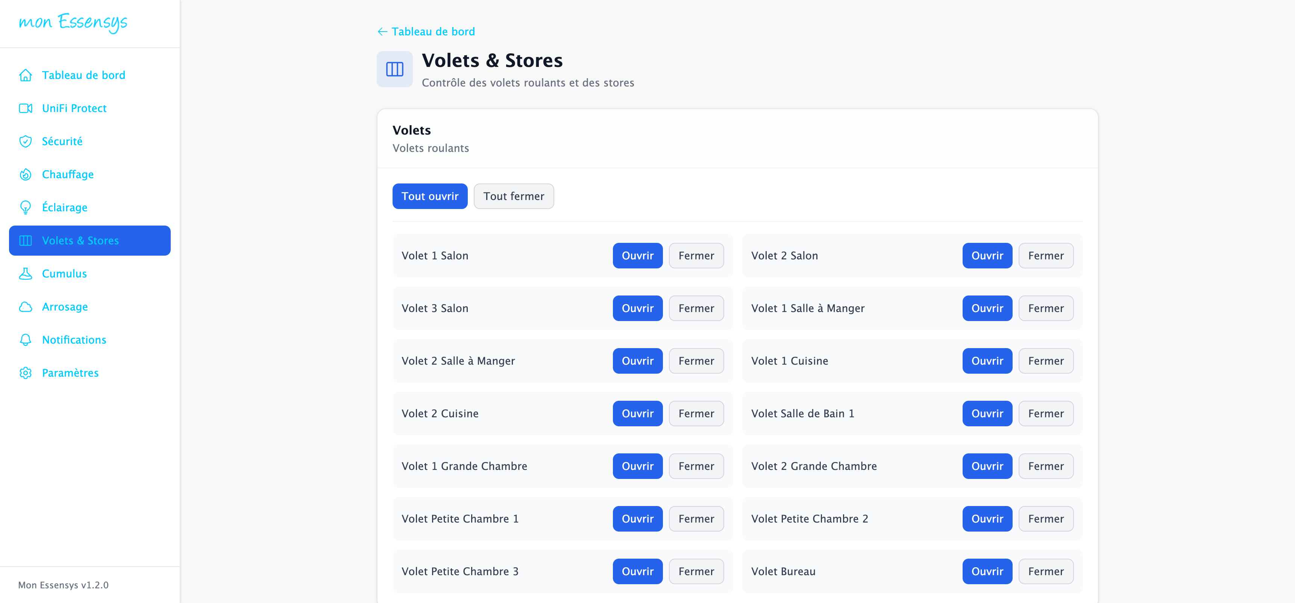
newsletters/2026-06-volets/assets/02-volets-controle.png
