essensys-hub/essensys-doc/newsletters/2026-06-volets/assets/03-volets-temps-course.png

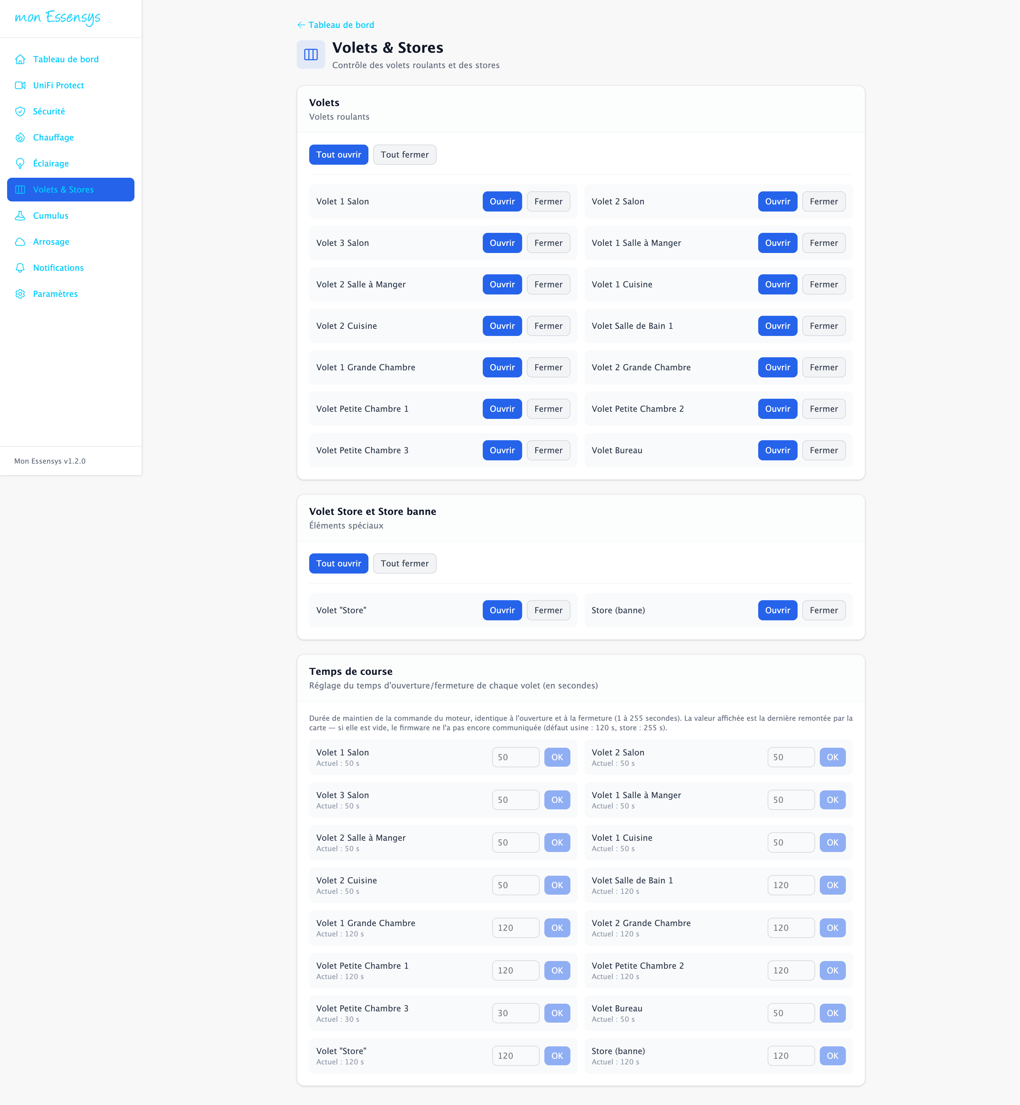
newsletters/2026-06-volets/assets/03-volets-temps-course.png
