essensys-hub/essensys-doc/newsletters/2026-06-volets/assets/04-temps-de-course.png

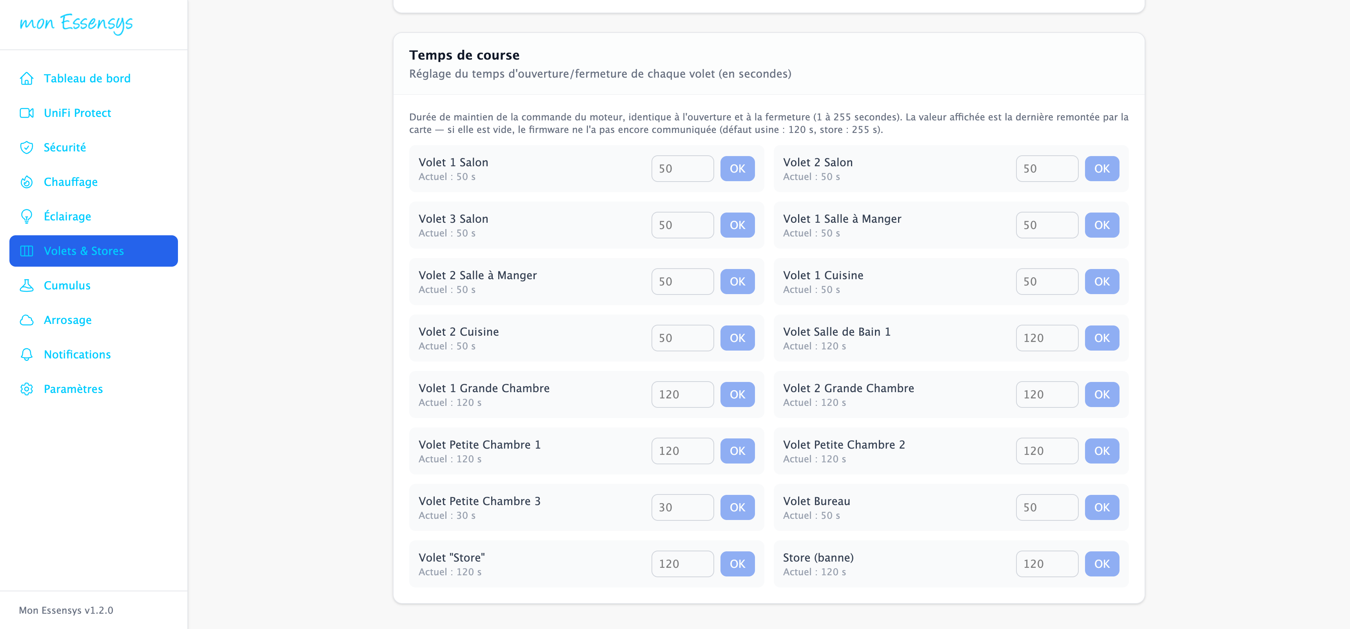
newsletters/2026-06-volets/assets/04-temps-de-course.png
