essensys-hub/essensys-doc/newsletters/2026-06-volets/assets/05-control-plane.png

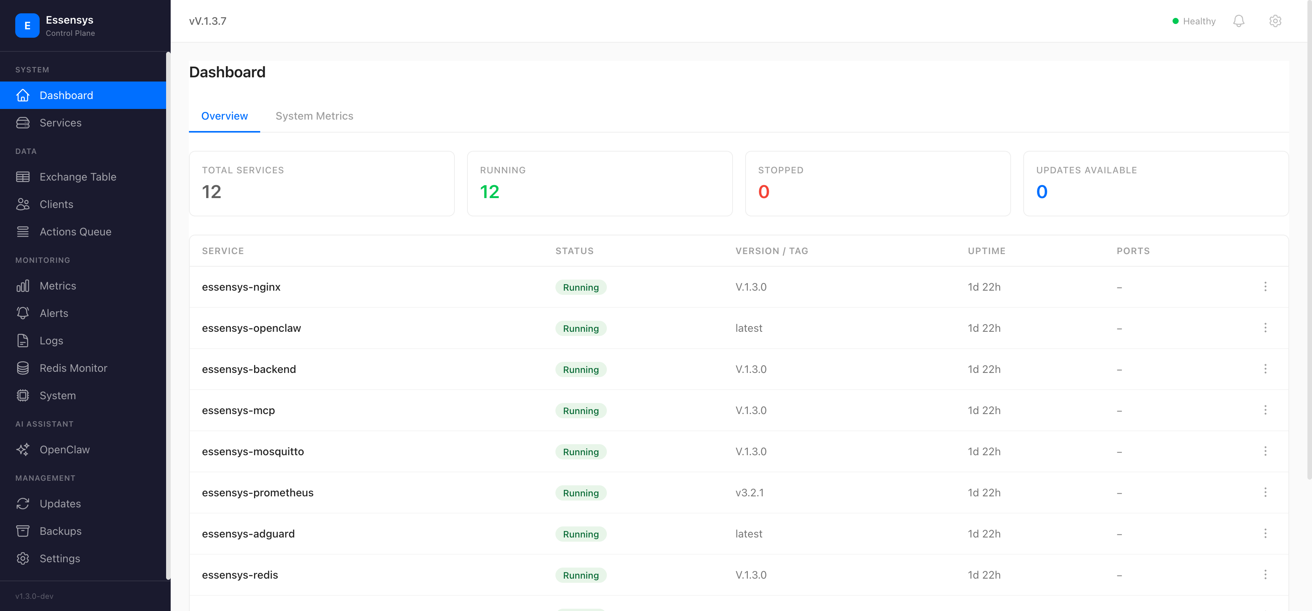
newsletters/2026-06-volets/assets/05-control-plane.png
