essensys-hub/essensys-doc/docs/retex/foudre-2026/archify/installation-chemins-surtension.html

Sombre

Style

Identité visuelleSS pour changer

ClassicStyle technique stable par défaut Flux de signalPrésentation animée et dynamique PlanRevue technique ÉditorialNotes de publication et de lancement

Animé Présenter

Exporter

Exporter le diagrammeDes exports portables et soignés

E

Partager Carte de partage d'itinéraire1200×630 PNG Carte de partage de portée1200×630 PNG Copier le diagrammePNG vers le presse-papiers

Image PNGImage sans perte JPEGImage compacte WebPImage au format moderne

Vecteur et animation SVG · AutoSuit le thème de la page hôte SVG · ClairToujours clair SVG · SombreToujours sombre WebMAnimation de 6 s

# Installation et chemins possibles de la surtension

Guide du diagramme Explorer ce diagramme ×

Inspection de la sémantique compilée

01 Trouver un nœudRechercher par libellés, responsabilités, types et identifiants stables. / 02 Tracer un itinéraireDécouvrez comment deux nœuds sémantiques sont reliés dans le sens édité. R 03 Voir tout le systèmeOuvrir le radar sémantique avec un viewport en direct et des nœuds stables. M 04 Comparer les types sémantiquesComptez les rôles, révélez leur trafic et comparez les liens édités directs. L 05 Entrer en mode présentationDonnez tout le viewport au diagramme en direct sans modifier l'export. F

E ExporterT ThèmeS Style0 Réinitialiser+ Zoom avant- Zoom arrièreEsc Fermer

Trouver un nœud ×

⌕ /

Aucun nœud correspondant

Passeport sémantique

Source vérifiée

Portée éditée

Amont0 Aval0

× Copier le lien Relations

Sonde d'itinéraire Choisir un nœud de départ Trouver le départ Copier le lien Effacer

Choisissez deux nœuds sémantiques sur le diagramme

← ▶ Parcours → Vue d'ensemble

Choisissez la source, puis la destination. Le sens compte.

Lentille sémantique Comparer les rôles du système ×

Choisissez jusqu'à deux types sémantiques. Un seul révèle son trafic réel ; deux comparent uniquement les relations éditées directes.

Choisissez un type pour inspecter ses nœuds et relations associées.

Copier le lien Effacer

Radar sémantique Construction de la vue d'ensemble Ouvrir le radar ×

Cliquer sur le nœudGlisser pour se déplacer

Le radar sémantique a besoin de plus d'espace MAP.

Notes et index

ROUTE CARTE LENTILLE 100%

### Établi

- 9 août 2026, fin d'après-midi : la supervision du PV tombe à 0 W
- Plus aucun BA ne répond au BP
- Vu en octobre : parafoudre AC du coffret PV aux fenêtres noires (date inconnue), parafoudres DC sans rouge, parafoudre du tableau au voyant vert
- Le dongle de supervision, sur le même switch que le BP, ne répond plus
- Les 4 cartes sont des îlots TBT flottants : seul le bus 4 fils (SDA, SCL, 0 V, +15 V) les relie

### Hypothèses concurrentes, non classées

- Témoignage : le disjoncteur de branchement a déclenché ; l'arrêt du PV en est alors la conséquence attendue, pas une preuve
- H-PV : foudre côté PV, puis Ethernet du dongle, switch, J32 du BP, 0 V du BP, bus
- Contre H-PV : sans amorçage, 3 capacités de 1 nF en série ne laissent passer que 0,3 à 1,7 A, loin des 11 à 20 A requis
- H-RÉS : mode commun côté réseau, vers le côté 230 V des BA ou les nappes J3. L'éclateur N-PE du tableau n'a pas de voyant
- Aussi ouvertes : H‑TOV (surtension temporaire, défaut d'onduleur, parafoudre AC en court-circuit qui ferait déclencher le disjoncteur) et H‑IND (indices sans lien)

### Le bus, pont entre îlots (déduit)

- Tronçons d'environ 33 cm : R + (L − M) ≈ 0,09 Ω + 0,09 à 0,16 µH entre une ligne et le 0 V
- Les écrêteurs I2C conduisent dès ≈ 20 A d'équilibrage en onde 8/20, ≈ 11 A sur un front rapide
- Le fil +15 V charge le rail du BA : U1 (24 V max) est atteint vers 28 A d'équilibrage (écart ≈ 10 V)
- Le SC940D, en bout de chaîne, a un seuil environ 3 fois plus bas, sans être pour autant désigné coupable

### Lire les liaisons

- Trait plein : liaison physique
- Tirets : chemin possible de la surtension (hypothèse)
- Rose : écoulement vers le PE par un parafoudre
- Accentué : bus I2C, seul lien galvanique entre les îlots
