essensys-hub/essensys-doc/docs/install/archify/module-n2-esp32.png

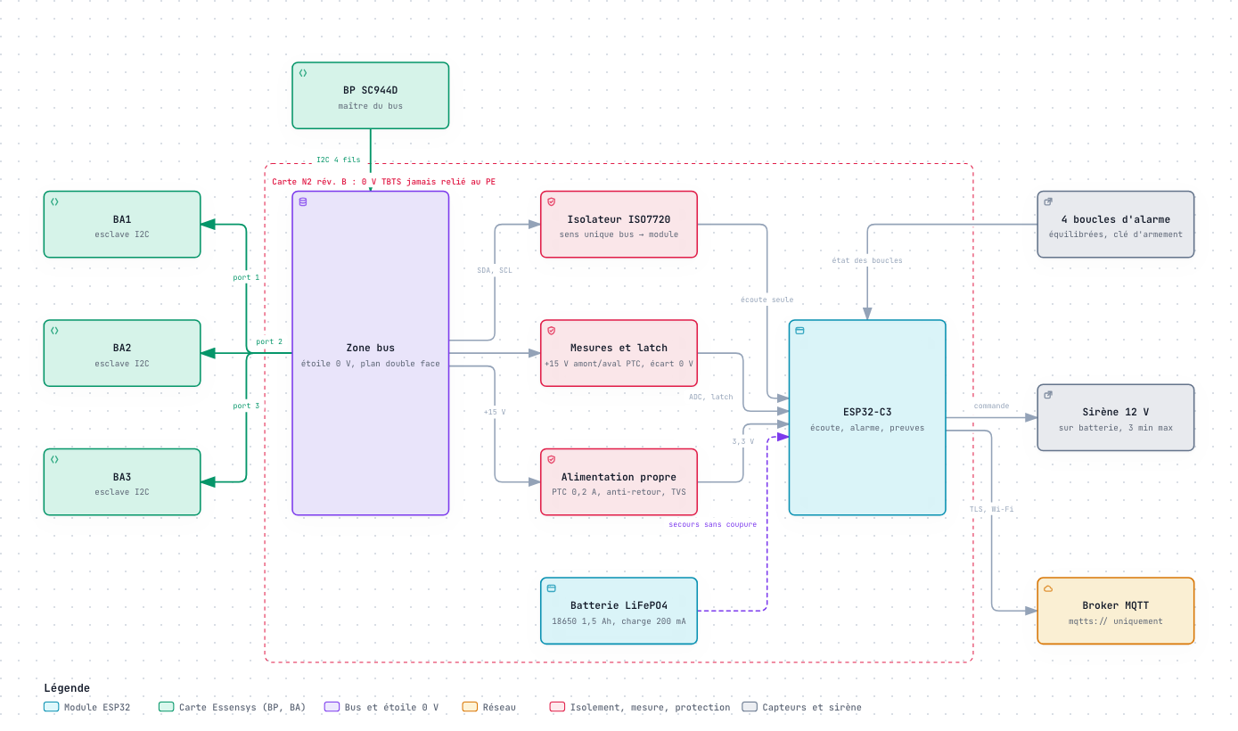
docs/install/archify/module-n2-esp32.png
