essensys-hub/essensys-doc/docs/retex/foudre-2026/archify/installation-chemins-surtension.png

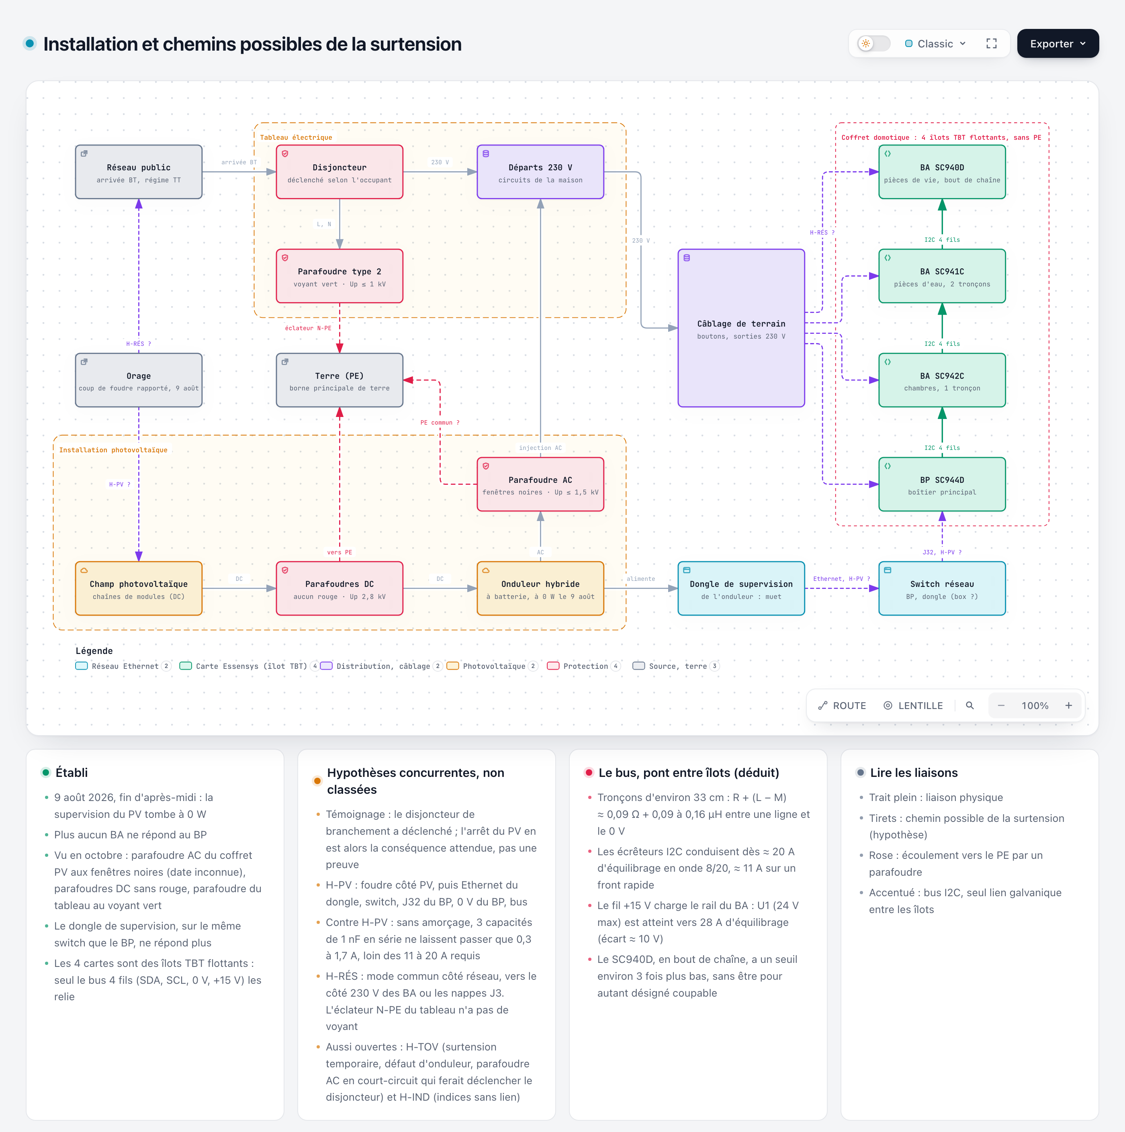
docs/retex/foudre-2026/archify/installation-chemins-surtension.png
