essensys-hub/essensys-doc/docs/debug/archify/espion-i2c.html

Sombre

Style

Identité visuelleSS pour changer

ClassicStyle technique stable par défaut Flux de signalPrésentation animée et dynamique PlanRevue technique ÉditorialNotes de publication et de lancement

Animé Présenter

Exporter

Exporter le diagrammeDes exports portables et soignés

E

Partager Carte de partage d'itinéraire1200×630 PNG Carte de partage de portée1200×630 PNG Copier le diagrammePNG vers le presse-papiers

Image PNGImage sans perte JPEGImage compacte WebPImage au format moderne

Vecteur et animation SVG · AutoMatches host theme SVG · LightAlways light SVG · DarkAlways dark WebMAnimation de 6 s

# Espion I2C passif : chaîne de debug du bus BP / BA

Guide du diagramme Explore this system ×

Inspection de la sémantique compilée

01 Trouver un nœudRechercher par libellés, responsabilités, types et identifiants stables. / 02 Tracer un itinéraireDécouvrez comment deux nœuds sémantiques sont reliés dans le sens édité. R 03 Voir tout le systèmeOuvrir le radar sémantique avec un viewport en direct et des nœuds stables. M 04 Comparer les types sémantiquesComptez les rôles, révélez leur trafic et comparez les liens édités directs. L 05 Entrer en mode présentationDonnez tout le viewport au diagramme en direct sans modifier l'export. F

E ExporterT ThèmeS Style0 Réinitialiser+ Zoom avant- Zoom arrièreEsc Fermer

Trouver un nœud ×

⌕ /

Aucun nœud correspondant

Passeport sémantique

Source vérifiée

Portée éditée

Amont0 Aval0

× Copier le lien Relations

Sonde d'itinéraire Choisir un nœud de départ Trouver le départ Copier le lien Effacer

Choisissez deux nœuds sémantiques sur le diagramme

← ▶ Parcours → Vue d'ensemble

Choisissez la source, puis la destination. Le sens compte.

Lentille sémantique Comparer les rôles du système ×

Choisissez jusqu'à deux types sémantiques. Un seul révèle son trafic réel ; deux comparent uniquement les relations éditées directes.

Choisissez un type pour inspecter ses nœuds et relations associées.

Copier le lien Effacer

Radar sémantique Construction de la vue d'ensemble Ouvrir le radar ×

Cliquer sur le nœudGlisser pour se déplacer

Le radar sémantique a besoin de plus d'espace MAP.

Notes & index

ROUTE CARTE LENTILLE 100%

### Masses et sécurité

- La sonde relie le 0 V de l'hôte à celui de l'armoire : hôte sur batterie, Wi-Fi seulement
- Branchement hors tension par une personne habilitée, jamais le +15 V
- Aucune émission sur le bus, aucun accès réseau au CM5

### Ce que l'outil distingue

- NACK d'adresse : BA absent
- Écho CRC 00 00 : trame rejetée par le BA
- Ligne SDA ou SCL bloquée au niveau bas
- Répétitions puis abandon du maître

### À ne pas confondre

- /api/done part avant l'I2C : action acquittée ≠ ordre reçu par le BA
- Trame validée CRC ≠ sortie physiquement commutée
