essensys-hub/essensys-doc/docs/debug/archify/espion-i2c.png

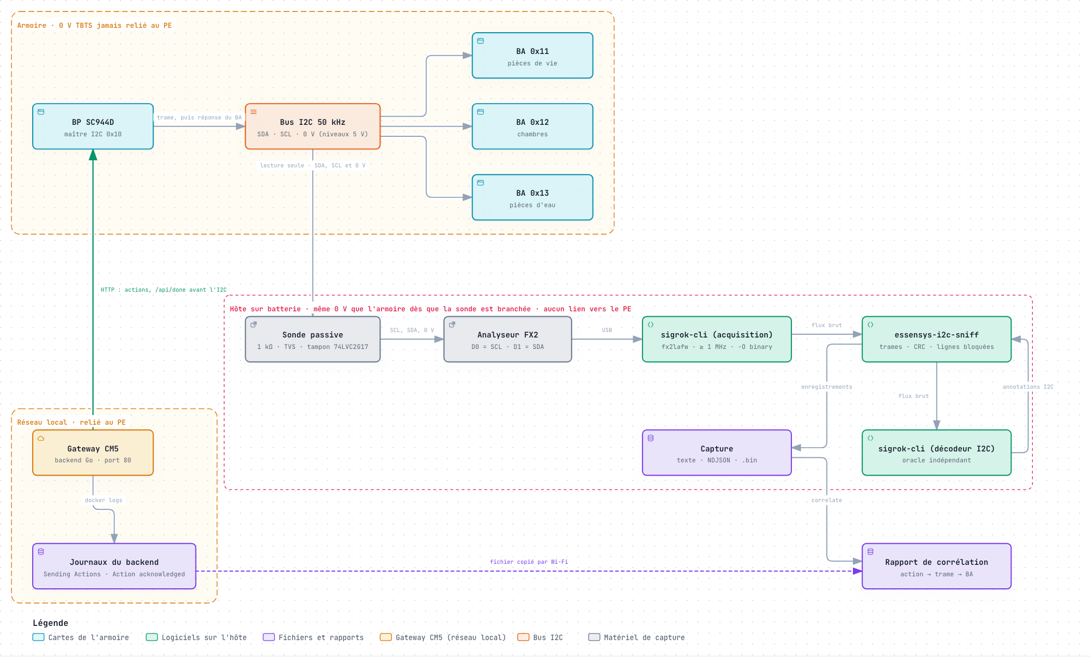
docs/debug/archify/espion-i2c.png
