essensys-hub/essensys-doc/(list of files, drawings)

Other design files:
docs/etudes/remplacement-armoire/marche/fritzing/domintell.fzz
docs/etudes/remplacement-armoire/marche/fritzing/eltako-series-14.fzz
docs/etudes/remplacement-armoire/marche/fritzing/esphome-rail-din.fzz
docs/etudes/remplacement-armoire/marche/fritzing/homematic-ip-wired.fzz
docs/etudes/remplacement-armoire/marche/fritzing/siemens-logo.fzz
docs/retex/foudre-2026/fritzing/etoile-0v.fzz
