essensys-hub/essensys-doc/(commit log)

2026-02-28 docs(archi): documentation architecture complete Essensys
    - index.md: diagramme C4 contexte avec tous les acteurs (WhatsApp, HA, Prometheus, UniFi, CI/CD)
    - legacy-client.md: specifications BP_MQX_ETH (Coldfire MCF52259, MQX RTOS, 8 contraintes firmware)
    - exchange-table.md: cartographie des ~600 indices de la table d'echange extraite du code C source
    - containers.md: les 14 services deployes avec descriptions et corrections (Support Portal = React+Go)
    - bridge-pattern.md: Anti-Corruption Layer, 4 points d'entree des ordres, flux complets
    - critique_ddd.md: autocritique mise a jour avec references vers les nouveaux documents et score revise
    Made-with: Cursor
2026-02-28 docs: diagrammes PNG, domaines fonctionnels et composants physiques BP_MQX_ETH
    - Ajout archi/diagrams.md avec 8 diagrammes Mermaid (architecture globale, flux,
    bridge, deploiement, table echange, conteneurs, 4 points entree)
    - Ajout archi/domaines-fonctionnels.md detaillant les 10 domaines (alarme,
    chauffage, volets, cumulus, prises securite, fuite eau, vent, arrosage,
    lave-linge, lave-vaisselle) avec indices, logique firmware et scenarios
    - Generation des 8 PNG dans archi/img/ via mermaid-cli
    - Mise a jour du diagramme architecture-globale avec tous les composants
    physiques du BP_MQX_ETH (3 BA, ecran, capteurs, actionneurs, EEPROM)
    - Mise a jour README.md avec section composants phy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
2026-02-28 fix: remplacer les diagrammes C4Context/C4Container/C4Deployment par graph standard
    GitHub ne supporte pas les types C4 de Mermaid. Conversion en graph TB/LR
    standard dans index.md, containers.md et deployment.md.
    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
2026-02-28 docs(archi): documentation detaillee du client legacy (securite, build, protocoles, GPIO, OTA, debug)
    Ajout de 6 sous-documents pour combler les lacunes identifiees par l'autocritique :
    - legacy-client-security.md : auth HTTP Basic (MD5+Base64), AES/Rijndael-CBC alarme, EEPROM SPI
    - legacy-client-build.md : toolchain CodeWarrior, makefile, structure projet, format S19
    - legacy-client-protocols.md : I2C (BA), UART (ecran, TeleInfo/Linky), SPI
    - legacy-client-config.md : mapping GPIO complet, peripheriques, parametres systeme, sequence init
    - legacy-client-deployment.md : bootloader, mise a jour OTA, flashing JTAG/BDM
    - legacy-client-testing.md : EspionRS, GPIO debug, CRC, surveillance, indica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
2026-02-28 docs(new_feature): specification firmware v2 — DNS local + status reel complet
    Proposition d'evolution du firmware BP_MQX_ETH en 3 phases :
    - Phase 1 : Migration DNS mon.essensys.fr → mon.essensys.local (AdGuard LAN)
    - Phase 2 : Envoi delta complet de la table d'echange (~600 indices) via /api/myfullstatus
    - Phase 3 : Nouvelle commande I2C C_LIRE_ETAT (code 6) pour retour d'etat physique des BA
    Inclut cartographie des 4 cartes (SC944D, SC940D, SC941C, SC942C), plan de migration,
    diagramme de flux v2 et analyse des risques.
    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
2026-02-28 docs(new_feature): reference technique MCF52259 / MQX RTOS / CodeWarrior
    Compilation de toute la documentation officielle NXP pour la programmation
    du firmware BP_MQX_ETH : MCU reference manual, ColdFire V2 architecture,
    MQX RTOS API, stack RTCS TCP/IP, drivers I2C, CodeWarrior IDE.
    Inclut resume API MQX (taches, mutex, semaphores, files de messages, GPIO),
    registres peripheriques MCF52259 et empreinte memoire.
    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
2026-02-28 docs(new_feature): autocritique technique firmware v2 — 8 erreurs et risques identifies
    Confrontation de la spec avec le code source reel des 4 firmwares :
    - ERREUR : table d'echange = 784 indices (pas 600), indices 600-630 deja occupes
    - CRITIQUE : reponse I2C BA fixe a 5 octets (TxBuf.b[4] + sl_fct_write_polled lit 5)
    → C_LIRE_ETAT 9 octets incompatible, proposer multi-transactions ou bitmask compact
    - ERREUR : TxBuf rempli dans ISR, pas main loop (timing 40ms vs immediat)
    - RISQUE : .local reserve pour mDNS (RFC 6762), preferer .lan
    - RISQUE : sync initiale 784/30 = ~52 secondes
    - Corrections des valeurs factuelles dans le corps de la spec
    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
2026-02-28 docs(new_feature): integration Home Assistant + errata table echange + corrections 953 indices
    - Ajout firmware-ha-integration.md : diagnostic existant, 4 axes d'amelioration,
    mapping complet des 14 categories d'entites HA, phasing en 5 phases
    - Ajout errata-table-echange.md : corrections a appliquer dans archi/ (953 indices, pas ~600)
    - Correction firmware-v2-local-fullstatus.md : 784 → 953 indices, sync 52s → 64s,
    indices BA repositionnes de 784+ a 953+
    - Deplacement mcf52259-mqx-skill-reference vers skills/
    - Ajout skills backend-reference-orders et raspberry-doc
    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
2026-02-28 fix(errata): remplacer ```mermaid par ```text pour les fragments de code
    Les extraits Mermaid dans l'errata ne sont que des fragments, pas des
    diagrammes complets. GitHub essayait de les rendre et echouait.
    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
2026-03-01 docs(new_feature): modernisation HTTP, HTTPS, mDNS/Bonjour et SSDP/UPnP
    Specification pour la modernisation de la pile Ethernet du firmware :
    - Diagnostic de l'existant (HTTP/1.1 en clair, MD5+Base64, pas de discovery)
    - 4 axes : securisation (TLS/HMAC), keep-alive, mDNS+DNS-SD, SSDP/UPnP
    - Analyse de faisabilite TLS (BearSSL ~9Ko RAM, critique mais possible)
    - Discovery reseau pour boxes Internet (SFR, Orange, Free, Bbox)
    - Mini-serveur HTTP local pour identification et description.xml
    - Phasing en 5 phases, estimation 3-8 semaines
    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
2026-03-01 docs(archi): documentation materielle complete des 4 cartes Essensys
    Ajout de 5 nouveaux documents dans archi/ decrivant le hardware :
    - hardware-overview.md : vue d'ensemble, comparatif, bus I2C, protections
    - hardware-sc944d.md : BP (MCF52259, Ethernet, 22 schemas, GPIO, BOM)
    - hardware-sc940d.md : BA PDV (PIC16F946, 17 relais, 3 variateurs)
    - hardware-sc941c.md : BA PDE (PIC16F946, 21 relais, 1 variateur)
    - hardware-sc942c.md : BA CHB (PIC16F946, 17 relais, 4 variateurs)
    Inclut le skill Altium Electronics Expert pour l'analyse de projets Altium.
    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
2026-03-01 fix(archi): autocritique v2 — corrections factuelles et liens croises
    Priorite 1 — Corrections factuelles :
    - ~600 → 953 indices (exchange-table, index, diagrams, README)
    - Format I2C BP→BA : 3 → 6 octets (legacy-client-protocols)
    - MQX 4.0 → 3.8 (hardware-sc944d)
    - "EEPROM SPI externe" → "Flash SPI SST25VF016B" (protocols, deployment)
    - Vacances indices 354-363 → 354-362 (exchange-table)
    Priorite 2 — Liens croises et navigation :
    - Lien vers hardware-overview et hardware-sc944d dans legacy-client.md
    - 7 liens firmware dans hardware-sc944d.md (section 10)
    - Bandeau navigation dans les 6 sous-docs legacy
    - Liens hardware dans legacy-client-config et -protocols
    Autocritique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
2026-03-01 docs(archi): corrections P3 (skill backend) et P4 (enrichissement)
    P3: Corrige port 7070→80, systemctl→docker, ajoute 4 cles Redis,
    documente les 4 points d'entree, corrige description MCP dans le
    skill essensys-backend-reference-orders.
    P4: Enrichit deployment.md (roles Ansible, Docker Compose, CI/CD),
    ajoute glossaire API legacy dans exchange-table.md (section 9),
    ajoute diagramme reseau LAN/WAN dans diagrams.md (section 11),
    clarifie references PNG manquantes.
    Score autocritique: 7.65/10 (+0.6)
    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
2026-03-01 docs(skills): ajoute skill mcf52259-mqx-expert corrige dans le depot
    Version corrigee : MQX 3.8 (pas 4.0), table 953 octets (pas ~600),
    Flash SPI SST25VF016B documentee, liens vers 9 documents archi/.
    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
2026-06-11 docs(archi): temps d'action volets detailles + correction decalage +8 des indices scenario
    - exchange-table.md 3.14 : indices exacts (566-589), mapping par volet,
    semantique du temps d'action (un seul temps pour les deux sens, defaut
    120 s / 255 s store, persistance Flash BP + EEPROM BA, reglage serveur)
    - Correction section 4 : base Scenario1 = 592 (et non 600), tous les
    indices absolus etaient decales de +8 (ex. ouvrir volets PDV = 617,
    pas 625) ; verifie contre firmware, MCP_DEVICE_INDEX_REFERENCE et
    table_reference.json Home Assistant
    - Correction des exemples JSON de domaines-fonctionnels.md (alarme 593,
    chauffage 625-628, securite 623, machines 624, cumulus 629, volets
    61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
2026-06-14 docs(newsletter): ajoute la release V.1.3.0 volets (juin 2026)
    Newsletter française avec captures gateway CM5 pour le réglage des temps
    de course par volet et le déploiement front/back V.1.3.0.
2026-06-21 feat(docs): site MkDocs Material pour publication OVH
    Hub docs.essensys.fr : nav architecture, guides install vendus depuis ansible, CI build strict.
2026-10-11 docs(retex): retour d'expérience foudre du 9 août 2026 (essensys-hub/essensys-board-SC944D#1) (#1)
    Nouvelle section « Retours d'expérience » : synthèse exécutive (une page)
    et analyse experte du coup de foudre qui a coupé le bus I2C BP↔BA, avec
    photos anonymisées, schémas Fritzing, diagrammes archify et schémas de
    vulgarisation.
    Corrections de build nécessaires à la publication :
    - CI docs-site : essensys-ansible épinglé sur V.1.3.0 (comme le rôle
    Ansible docs_site) ;
    - prepare-docs.sh : secrets.md ajouté aux liens réécrits, et liens
    pointés sur V.1.3.0 (5 des 7 documents n'existent pas sur main).
    Feature: i2c-surge-protection-2026-10-007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
2026-10-12 docs(retex): carte N2 étoile 0 V et dépôt essensys-i2c-etoile-0v (#2)
    Feature: i2c-surge-protection-2026-10-007
2026-10-12 docs(retex): seuils de l'étoile 0 V alignés sur le modèle corrigé (essensys-hub/essensys-board-SC944D#1) (#3)
    N2 : environ 80 à 120 A en onde 8/20 et 50 à 65 A en front rapide
    (4 à 6 fois la référence), au lieu de 173 A / 79 A : la liaison unique
    vers J31 n'est pas doublée. Texte, graphique et notes Fritzing.
    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
2026-10-12 docs(install): module N2 ESP32, installation, alarme et MQTT (essensys-hub/essensys-feature-lifecycle#28) (#5)
    Tâche 9.2 du change n2-esp32-spy-alarm-2026-10-008.
2026-10-12 docs(install): schéma archify du module N2 à la place du Mermaid (essensys-hub/essensys-feature-lifecycle#28) (#6)
2026-10-12 docs(install): procédure post-surtension, guide de protection et corrections matériel (#1) (#4)
    - nouvelle page « Diagnostic et remise en service après une surtension » (E-1, E0, E1/E2, établi, réception, relance 13 s, règles BREAKING, firmware qualifié seulement)
    - nouvelle page « Protection contre les surtensions » (parafoudre, terre, PE, goulottes, câble de bus, N2, MIB), chaque règle liée à aux-box-interconnect
    - hardware-sc944d/overview : liaison BA par J31 (Micro Mate-n-Lok), J3 = E/S terrain
    - hardware-sc940d/941c/942c : bus par J1/J2, J3 = entrées TOR, logique 5 V, L3 non montée, quantités TVS/VDR selon BOM DM
    Refs essensys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
2026-10-13 docs(install): procédure d'ajout ou de remplacement d'un BP sur gateway CM5 (#7) (#8)
    Nouvelle page docs/install/ajout-bp.md :
    - la clé d'accès à distance n'est plus nécessaire avec la gateway CM5
    (authentification désactivée, file d'actions globale), et pourquoi elle
    bloquait tout avec l'ancien serveur ASP.NET ;
    - ce qui reste dans l'ancien BP (configuration RWS en flash, code alarme,
    clé en EEPROM) et la configuration des BA à renvoyer ;
    - contrôles de mise en service en lecture seule (voyant CABLE>DHCP>DNS>SERVEUR,
    bail DHCP, journaux, index 12) ;
    - avertissement : le BP acquitte /api/done avant l'envoi I2C.
    Refs essensys-hub/essensys-board-SC944D#2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
2026-10-13 docs(debug): section Debug et page « Espion I2C passif » (essensys-hub/essensys-doc#9) (#10)
    - docs/debug/index.md : outils de debug, règles communes (passif, hors
    tension, aucun pont de masse) ;
    - docs/debug/espion-i2c.md : principe, matériel, sécurité, fabrication de la
    sonde (schéma KiCad, câblage Fritzing, contrôles), installation, mode
    opératoire (un seul essai par clic), lecture des captures, corrélation avec
    la gateway, limites ;
    - schéma Archify de la chaîne de debug (source JSON versionnée, HTML, PNG) ;
    - liens depuis install/ajout-bp.md et install/remise-en-service-surtension.md.
    Feature: i2c-ba-sniffer-2026-10-009
    Refs essensys-hub/essensys-feature-lifecycle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
2026-10-13 docs(debug): schémas de l'espion I2C corrigés (essensys-hub/essensys-doc#9)
    - Archify : zone « même 0 V que l'armoire » englobant sonde et hôte, liaison
    gateway CM5 → BP (HTTP, /api/done avant l'I2C), vrai trajet des données
    (deux sigrok-cli), BA génériques, légende en vocabulaire métier, visualiseur
    en français, image de repli propre (mode embed, sans barre d'outils) ;
    - KiCad : schéma câblé recadré ;
    - Fritzing : plan d'implantation et montage d'ensemble (connecteur 2x2 réel,
    batterie, câble USB, masse commune, Ethernet barré) ;
    - texte : nouvel ordre de J2, masse commune (GND de l'analyseur et broche 9),
    branchements du mode opératoire, marquage CH0/CH1 des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
2026-10-14 docs(retex): suivi du diagnostic foudre au 14 octobre 2026 (essensys-hub/essensys-board-SC944D#2)
    Synthèse, analyse experte et page d'accueil du retex mises à jour avec les
    analyses en cours :
    - BP et BA de bout de chaîne remplacés ; le nouveau BA répond, le SC942C et
    le SC941C restent muets (index 12 = 0x18) ; bus sain, défaut local ;
    - fausses pistes écartées : clé d'accès à distance, appairage ;
    - démarrage du BP et des BA, acquittement avant envoi I2C, défaut après 5
    échecs, abandon après 20 ;
    - protocole selon la version du firmware BA (somme 8 bits jusqu'à 1.4, CRC16
    à partir de 1.5) ;
    - causes restantes et tableau pour trancher (LED DL1, console de diagnostic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
2026-10-14 docs(retex): sous-listes du suivi foudre en retrait de 4 espaces (essensys-hub/essensys-board-SC944D#2)
    Python-Markdown n'imbrique une liste qu'avec un retrait de 4 espaces : les
    sous-listes des sections « Où en est-on ? » et « Suivi du diagnostic »
    s'affichaient à plat.
2026-10-14 docs(retex): fiche illustrée de contrôle du BP au multimètre (essensys-hub/essensys-board-SC944D#1)
    Nouvelle page retex/foudre-2026/controle-bp-multimetre.md : 39 points
    numérotés sur les photos des deux faces du SC944D (positions issues du
    fichier de placement), mesures hors tension puis sous alimentation de
    laboratoire 24 V, valeurs attendues tirées du schéma, interprétation.
    Liens depuis retex/index.md et le §9.4 de l'analyse experte.
2026-10-14 docs(retex): banc du 14 octobre, l'ancien BP tient SDA à 0 (essensys-hub/essensys-board-SC944D#2)
    Analyse experte, section « Suivi du diagnostic » : nouvelle sous-section
    « Banc du 14 octobre » (#banc-bp).
    - Montage : BP seul, analyseur FX2 + sigrok à 1 MHz sur J31.
    - Note d'alimentation : sous 16,5 V en entrée, le LM3150 décroche, d'où
    10 V puis 12 V sur BA_ALIM.
    - Capture de 3 min avec deux coupures : SCL saine, SDA à 0 en permanence ;
    pas de trame, ce qui est attendu sans ordre.
    - Interprétation : le BP d'origine bloquait le bus (§8).
    - Suspects (D34, U19, câble) et mesures A/B/C en cours.
    - Deux figures : chronogrammes et photo annotée des composants.
    Encadré de statut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
2026-10-14 docs(retex): ancien BP, SCL collée par D33 en court-circuit (essensys-hub/essensys-board-SC944D#2)
    Correction de la sous-section « Banc du 14 octobre » de l'analyse experte :
    - la ligne collée à 0 est SCL, pas SDA. Les couleurs du câble de banc
    étaient inversées (lecture en miroir côté fils), ce que signale un
    encadré d'avertissement ;
    - D33 (SMF5V0A, diode de BA_SCL) conduit dans les deux sens ; la zone
    entre L30 et D33 paraît noircie. Gros plan annoté ajouté ;
    - réparation, d'après la note retouche foudre du SC944D (tâche 3.2) :
    déposer D33 ; contrôler L30, R156 et D34 ; remplacer D33, D34
    (SMF5V0A-E3-08) et U19 ; vérifier par une capture START/0x22/NACK ;
    - p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
2026-10-14 docs(retex): banc du 14 octobre, D33 déposée, le BP appelle de nouveau les BA (essensys-hub/essensys-board-SC944D#2)
    Nouvelle sous-section #banc-bp-apres-d33 : montage passerelle de banc
    (DHCP + DNS mon.essensys.fr + essensys-server-backend), trois ordres
    injectés, adresses 0x11/0x12/0x13 émises 21 fois puis abandonnées (NACK,
    aucun BA raccordé), SCL revenue à 1, horloge ~44 kHz. Observation à
    expliquer : SCL seule à 0 pendant 63 s lors d'une coupure.
2026-10-20 docs: études de remplacement des cartes de l'armoire (Revolution Pi, Arduino Opta, Raspberry Pi)
    Claude-Session: https://claude.ai/code/session_01H8ymfNw4FxQYLsTMQmryvM
2026-10-20 docs(etudes): repiquage des phases par blocs Wago dans les trois études
    - Nouvelle section « Repiquer une phase sur plusieurs relais » : repiquage
    actuel sur les cartes BA (photo annotée), blocs de phase X3 en bornes à
    quatre points Wago 2002-1401 reliées par un contact de pontage 2002-4xx,
    un fil par point, règles (un disjoncteur par bloc, 16 A en 1,5 mm²,
    phase et neutre sur le même disjoncteur, neutres du BP séparés) et
    migration (pré-câblage, bascule, retour arrière).
    - Répartiteur X1 porté à 56 bornes (112 circuits), réserve TBT précisée.
    - Totaux mis à jour : 5 450, 5 600 et 3 160 € HT.
    - Schémas Archify (repiquage, plan de bornage, câblage), vues 3D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
2026-10-23 docs(etudes): bandeau « V1 figée » sur les trois études V1
    Les trois études V1 (Revolution Pi, Arduino Opta, Raspberry Pi et
    Ethernet) sont figées depuis le 21 octobre 2026. Un bandeau remplace la
    ligne d'auteur : il dit pourquoi elles ne tiennent pas l'exigence de
    résilience et renvoie vers l'autocritique, l'étude V2 « filaire
    d'abord » et la page de synthèse. Le texte des études est inchangé.
    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
2026-10-23 docs(etudes): V2 « filaire d'abord » et réponse à l'exigence de résilience
    Après la foudre du 9 août 2026, l'armoire doit rester utilisable si son
    électronique meurt : les 63 boutons commandent toujours leurs charges,
    en filaire, et la domotique devient une couche ajoutée.
    - etudes/resilience.md : l'exigence, pourquoi les V1 n'y répondent pas,
    l'architecture retenue, les replis, le coût, les preuves à apporter,
    les désaccords ouverts et la feuille de route.
    - remplacement-armoire/v2/ : étude V2 « filaire d'abord, domotique en
    dérivation », verdict du conseil d'autocritique (méthode : six agents
    d'IA dans des rôles d'expert), autocritique des trois études V1,
    ca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
2026-10-23 docs(retex): renvoi de la foudre de 2026 vers la réponse de résilience
    La présentation des retours d'expérience et la synthèse de la foudre
    renvoient vers « Répondre à l'exigence de résilience » et les études de
    remplacement des cartes.
    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
2026-10-23 build(docs): exclure selectolax 1.0.1, qui fait disparaître les images
    Avec selectolax 1.0.1, mkdocs-glightbox 0.5.2 retire toutes les balises
    <img> du site, retours d'expérience compris, sans aucun avertissement,
    même en mode strict. Les versions 0.4.13, 1.0.0 et 1.0.2 gardent les
    images, entourées de leur lien glightbox (essais du 23 octobre 2026).
    On exclut donc seulement la 1.0.1.
    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
2026-10-24 docs(etudes): corrections de la relecture indépendante du comparatif « Solutions du marché » (#19)
    ESPHome reclassé « non tenue » (micrologiciel du projet), prix de l'EUD12D-UC
    unifié, repère Revolution Pi unique, cas « hors contrainte » traités de la même
    façon (KNX, Homematic, LOGO! 230 V), totaux recalculés, rumeur non vérifiée
    retirée du dossier Domintell.
    Refs essensys-hub/essensys-doc#19
2026-10-24 docs(etudes): schémas Archify et câblages Fritzing des onze dossiers « Solutions du marché » (#21)
    Chaque dossier du comparatif reçoit deux schémas Archify interactifs
    (« seule » et « en dérivation ») avec image fixe dépliable, et un câblage
    Fritzing d'un poussoir à une lampe avec son fichier .fzz. Les sources JSON
    des schémas et le générateur Fritzing sont versionnés avec le site, avec
    leurs scripts de construction. L'index du comparatif explique les schémas.
    Les câblages sont des principes, non validés au banc ; les schémas ne
    disent rien que le dossier ne dise.
    Refs essensys-hub/essensys-doc#21
2026-11-06 docs(utilisation): régler l'extinction automatique des lumières (#23)
    Nouvelle page (menu Temporisations, fiche lumière, valeurs, valeur libre,
    limite de l'écran de l'armoire) et table d'échange corrigée (cases 518, 534,
    550 ; clés 521, 555, 556, 557, 561, 562 ; 0 à 255 min, 0 = jamais).
    Feature: lumieres-temporisees-2026-11-003
    Refs essensys-hub/essensys-feature-lifecycle#45
2026-11-07 docs(utilisation): renommer une lumière et fichier des noms de la gateway (#25)
    Page « Renommer une lumière » (droits, règles du nom, nom d'origine,
    synchronisation, limites), page d'installation sur le fichier
    light-names.json de la gateway (emplacement, sauvegarde, 503
    names_unavailable) et entrées de menu.
    Feature: noms-lumieres-2026-11-004
    Refs essensys-hub/essensys-feature-lifecycle#41
2026-11-07 docs(utilisation): renommer un volet ou un store et section shutters du fichier des noms (#27)
    Page « Renommer un volet ou un store » (jumelle de « Renommer une lumière ») avec
    entrée de menu, et fichier des noms de la gateway documenté avec ses deux sections
    (lights, shutters), sauvegarde, 503 names_unavailable et retour arrière.
    Feature: noms-volets-2026-11-005
    Refs essensys-hub/essensys-feature-lifecycle#52
    Refs essensys-hub/essensys-doc#27
2026-11-07 docs(utilisation): masquer et ordonner les lumières et les volets, sections de disposition du fichier gateway (#29)
    Page « Masquer et ordonner les lumières et les volets » (jumelle de « Renommer un
    volet ou un store ») avec entrée de menu ; fichier des noms de la gateway documenté
    avec ses quatre sections (lights, shutters, lights_layout, shutters_layout), ordre de
    déploiement cloud puis gateway et risque d'une gateway restée à une version plus ancienne.
    Feature: affichage-objets-2026-11-006
    Refs essensys-hub/essensys-feature-lifecycle#55
    Refs essensys-hub/essensys-doc#29
2026-11-08 docs(utilisation): sonnette UniFi, configuration UniFi de la gateway et section doorbell (#31)
    Page « Sonnette UniFi » (prérequis, activation, lumières, essai, droits, limites :
    instantanés environ une image par seconde, clignotement lent), page de configuration
    UniFi de la CM5 avec dépannage doorbell_unavailable et names_unavailable, section
    doorbell du fichier des noms, entrées de menu.
    Feature: sonnette-unifi-2026-11-007
    Refs essensys-hub/essensys-feature-lifecycle#58
    Refs essensys-hub/essensys-doc#31
2026-11-08 docs(utilisation): lumières de la sonnette finissant allumées, sans restauration (#31)
    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
2026-11-08 docs(sonnette): plages horaires, notifications push et installation des fournisseurs (#61)
2026-11-11 docs(debug): synthèse du banc de test du BP SC944 (#36)
    Refs #36
2026-11-11 docs(debug): banc de test des BA, correction de la page du banc BP (#38)
    Refs #38
